siska-tech/kagura-hd/docs/pcm-stream-rc1-sta-audit.md

# PCMストリーミング RC1 STA改善監査

監査日: 2026-11-07。対象は `diagnostics/pcm-stream-rc1/` の3本のSTAパッチ、ビルド・再配置スクリプト、`build/pcm-stream-rc1/sta-short-control/` の保存済みRTL・ログ・STA。今回は静的レビューと保存証跡の照合を実施し、合成・シミュレーション・実機試験は再実行していない。

## 判定

改善方向は妥当。ただし採用保留。最良P4/R2はSetup +0.090 ns、Hold +0.530 ns、違反端点0/0であり、既定Setup +0.100 nsに0.010 ns不足する。CLS 4265/4320（残55）、BSRAM 23/26。数値は保存済み `native/timing-status.json` と `native/impl/pnr/kagura_fb.rpt.txt` に整合する。試験不足を解消してから次のSTA候補を評価する。

## 指摘

### P1: 新設した桁上がり境界の試験が未成立

`control-sta.patch` は `cursor[10:3]` の全ビットANDを登録し、上位 `cursor[19:11]` の加算に使う。cursorはbyteではなく32-bit word単位。対象は2048 wordごとの境界であり、例えばword 2044から16 wordを読み書きする試験が必要。

保存済み `sta-short-control/tb_fb_burst_ctrl.sv:65` の追加ケースはword 508から16 word。これは512 word境界で、分割した上位加算のcarry=1を検証しない。モデルは4096 byte、ランダム開始アドレスは0〜1008 wordで、正常転送の検証範囲も新境界に届かない。READMEの「桁上がり境界を確認した」は今回の変更に対する証拠として不十分。RTLの不具合を確認したものではなく、carry=1の動作保証が欠ける指摘である。

対応: モデルと期待メモリを拡大し、2044/2047開始のマスク付き書込み・読出し、複数の2048 word境界、carry後の次要求を試験する。アサートがcarry=1のPREPAREを実際に観測したことも記録する。

### P2: 回帰試験を新しい作業環境で再現する手順が不足

`build.ps1` はパッチ適用とP&R・数値ゲートを行うが、機能回帰は実行しない。READMEの実行例は `tb_stream` に限られ、境界追加済みバースト試験は `build/` 内、Queue8用基板トップ試験も生成済みファイルに依存する。HDMI比較のseed・REPLICATE_FIRST指定を含む一括再現手順と試験入力manifestがない。

保存ログにはHDMI比較3 seed、バースト、基板トップ回帰の実行証跡がある。packet-build.logのパラメータ警告からREPLICATE_FIRST=1でのビルドも確認でき、既存結果を否定する指摘ではない。ただし後のパッチ変更で検証を省略しやすい。

対応: 試験fixtureまたはその生成差分をdiagnostics側に保存し、assert有効・seed・対象入力hashを記録する回帰スクリプトを用意する。最終パッチ組合せでstream試験も含めて実行する。

## 妥当性と制約

- TXロード予測はIDLE維持、無効要求のCHECK→IDLE、GAP→IDLEを網羅する。シフト予測は通常転送のtickを1サイクル先読みし、現行LAT/RDL設定で元条件と整合する。既存assertは有効な防護。FSM変更時には予測条件も同時に変更する必要がある。
- HDMI式はfirst=(counter==0)、last=(counter==31)という既存不変条件から元のcounter_next==0と等価。既存の初期値とresetも整合する。
- cursorのcarryは要求受付後のCHECKで更新され、PREPAREで消費される。次バーストまでにも更新時間がある。静的レビューでは位相不整合は見つからなかったが、上記境界試験は必要。
- 窓選択の複製は大きなデータ保持段を増設しない方針に適合する。ただし受付条件を二重記述しており、CSR変更時の追随とbyte_commitとのassertを維持する必要がある。
- 最良版とRC1のSDCのSHA-256は一致（169C6026948136C552BB5AB498D3F44C84FA390342433AC3F993745F253C1AA0）。今回の改善は制約緩和によるものではない。
- そのSDC自体はdraft。system54/pixel74間の一律10 ns max-delay、同区間のhold除外、host入出力のfalse pathを含み、PSRAM外部IOの完全な仕様ではない。数値ゲート通過をCDCプロトコル・外部IO・実機動作の承認と扱わない。これは既存の評価範囲であり、新たに導入された欠陥ではない。
- 旧パレット配置指定の転用でSetupが−1.109 ns、bit181単独指定で−1.971 nsに悪化した。局所FFを寄せることと全体STA改善は一致しない。現行の内部配置指定なしP4/R2を保持し、全経路の数値で採否を決める。

## 次の順序

1. 桁上がり境界試験と回帰再現手順を整備する。
2. 同一入力を固定して追加候補を比較し、Setup +0.100 ns基準を維持する。+0.090 nsを丸めて合格にしない。
3. 数値ゲート達成後に、既存のCDC・外部IO評価範囲を明示した実機ストリーミング検証へ進む。

## 監査後の対応（2026-11-07）

P1/P2の機能検証・再現手順不足は対応済み。`diagnostics/pcm-stream-rc1/regress.py` と保存fixtureを追加し、RC1入力から全パッチを再適用して11実行が成功した。2048/4096/6144 word境界は3 seedそれぞれでcarry=1読出し6回・書込み6回を観測した。再生成した入力41ファイルは最良STA版と改行差を除いて一致。詳細は同ディレクトリのREADME、証跡は `build/pcm-stream-rc1/audit-regression/`。STA採用保留と実機未検証の判断は継続する。
