siska-tech/kagura-hd/docs/publication-audit.md

> 履歴資料：この文書の未検証・候補・公開保留などの記述は記録時点の状態です。最終版の選定と現行仕様は [リリース案内](release-validation.md) と [README](../README.md) を参照してください。

# KAGURA-HD 公開用スナップショットの監査

2026-11-04。公開先は https://github.com/siska-tech/kagura-hd です。GitHubリポジトリ作成とPushは最終承認待ちです。

## 公開対象と原本の保護

開発側488候補を全件選別し、旧Desktop・ゲーム・旧SDKの測定ログと画像、開発専用の整理台帳223ファイルを公開対象から除外しました。265ファイルを継承し、NOTICEと本記録の2ファイルを追加した **267ファイル** を初期公開対象とします。

開発ツリー、未コミット変更、ローカルバックアップを保護しています。全488ファイルの開始時SHA-256との照合で開発ファイルの変更は0件でした。公開側のRTL・基板・モデル・ドライバ・第三者コードも内容を維持しています。kagura_fb_*、KFB1、ABI 1.2、API名、公開対象のソースパスを維持しました。

共通部品と診断Topの再ビルド用に継承RTL・制約・診断ツールを保持しました。旧仕様入力や設計資料は診断構成の背景資料です。現行仕様は [README](../README.md) と [ホストABI](kagura-fb-host-api.md) に示しています。原本の選別一覧と除外理由は開発側 build/publication-audit/file-decisions.csv に保存しています。

## READMEと参照の監査

READMEを正式名称 KAGURA-HD、現行仕様、ビルド方法、実測の検証値、実機未検証事項に合わせて全面改訂しました。過去の設計・実装記録と継承した診断資料には、当時の名称・ABI・数値を現行仕様と区別する注記を追加しました。

旧資料への相対リンク21件を継承元の固定コミットへ変更しました。全Markdownのローカルリンクとアンカーを走査し、参照先不明は0件です。外部URL38件は、公開先の作成待ち1件を除き参照先を確認しました。Raspberry Piの公式仕様ページはHTTP HEADで403となったため、別の閲覧経路で公式ページの内容を確認しました。

Dynabook手順のSPI例は既存connect_rp2040()を使う形に修正しました。指定のGP2/3、GP6/7配線に対してSoftSPIを生成する実装を使用します。

秘密鍵ヘッダ、GitHub token、AWS access key、直接代入された長い秘密文字列のパターン検査は該当0件です。個人ホームの固定絶対パスを資料から除去しました。Gowinの上書き可能な既定インストール先と、説明用プレースホルダーは保持しています。1 MiB超の公開ファイルは0件で、bitstream・波形・キャッシュ・生成物はGit管理対象に含めません。

## 公開スナップショットからのクリーン検証

|検査|結果|
|---|---|
|Verilator 5.032、seed 1 のFB回帰|26件合格|
|共通HDMI・音声・メモリの直接回帰|22構成合格|
|C/Pythonドライバ|15件合格|
|MicroPython Unix v1.26.0|3グループ合格|
|BLIT解析|終了コード0|
|HDMI固定依存SHA-256|12ファイル一致|
|全公開シェル入口|bash構文検査合格|
|CI設定|YAML解析、実行入口と固定タグのコミット一致を確認|

CIのVerilatorタグv5.032は8ff77e9d47351b0a59114929880687839a51840b、MicroPython v1.26.0は4ce2dd2cdab6e57f3982fc899f15a2103d71b0beに一致しました。実MicroPython試験にも後者のソースからビルドしたランタイムを使用しました。GitHub Actions上での実行はリポジトリ公開後の確認対象です。

既存ソースのCRLFと第三者原版の空白を維持しています。初期コミット全体の空白検査には継承ファイルの末尾空白・末尾空行の警告が残ります。これは既存ソースの表記を保持した結果で、RTLやドライバの書換えによる整形は行っていません。

## Gowin SPI/QSPIのクリーンP&R

Gowin Education 1.9.11.03で公開スナップショットから新規に合成・配置配線しました。

|構成|Logic|FF合計|CLS|BSRAM|DSP|Setup ns|Hold ns|違反|
|---|---|---|---|---|---|---|---|---|
|spi|7815|5227|4245|19|1|1.122|0.558|0|
|qspi|7795|5230|4223|19|1|0.66|0.552|0|

資源・slackは開発側と一致しました。SPI/QSPIの.binは開発側とバイト単位に完全一致しました。.fsと.binxは生成時刻ヘッダのみが異なりました。SHA-256は次のとおりです。

- spi .bin `9cf73240289361fa89cbb4affb2821da210896a47298578b279656fb3ee045cf`
- spi .fs `ea716f2c7ecee681c2a4b6fe13b62629d473dade7d454e42d3abdd8b7a1387b0`
- qspi .bin `2b51dfe0c120d1cf4b4438d366239b1a13a76ca7dbb74ec619583f76381c1b14`
- qspi .fs `57d3e2262d12b644c4a7edd8ac864b51ef56637ffcc6499ed0a68d6221752bc5`

数値STAは合格しています。CDC制約の妥当性、外部PSRAM I/Oタイミング、実機の映像・音声品質と最大ホスト速度、長時間安定性は未検証です。timing-status.jsonのrelease_readyはfalseです。実機書込み・接続は今回実施していません。

## ライセンスと初期コミット

本体は [Apache-2.0](../LICENSE) です。[NOTICE](../NOTICE)、[第三者表記](../THIRD_PARTY.md)、[継承元](kagura-fb-separation.md)を保持しました。hdl-util/hdmiはApache-2.0側を選択し、Copyright 2019 Sameer PuriとMIT/Apache-2.0の両本文を保持しています。

公開側に新規Gitリポジトリとmainブランチを作成し、旧履歴を取り込まず、この検証済み内容の単独初期コミットを準備します。初期コミットIDはgit rev-parse HEADで確認できます。originは承認済み公開先に設定しました。GitHubのリポジトリ作成とPushはユーザーの最終承認待ちです。
