siska-tech/kagura-hd/releases/pcm2-spi/reports/kagura_fb.rpt.html

- PnR Messages
- PnR Details
- Resource
  - Resource Usage Summary
  - I/O Bank Usage Summary
  - Clock Resource Usage Summary
  - Global Clock Signals
  - Pinout by Port Name
  - All Package Pins

# PnR Messages

Report Title | PnR Report
Design File | C:\Users\Shion\Documents\Projects\kagura-hd\build\kagura-fb\impl\gwsynthesis\kagura_fb.vg
Physical Constraints File | C:\Users\Shion\Documents\Projects\kagura-hd\build\kagura-fb\kagura_fb.cst
Timing Constraints File | C:\Users\Shion\Documents\Projects\kagura-hd\boards\tang-nano-9k\kagura-fb.sdc
Tool Version | V1.9.12.04 (64-bit)
Part Number | GW1NR-LV9QN88PC6/I5
Device | GW1NR-9
Device Version | C
Created Time | Fri Nov 6 07:12:30 2026
Legal Announcement | Copyright (C)2014-2026 Gowin Semiconductor Corporation. All rights reserved.

# PnR Details

Place & Route Process

Running placement: Placement Phase 0: CPU time = 0h 0m 15s, Elapsed time = 0h 0m 15s Placement Phase 1: CPU time = 0h 0m 0.326s, Elapsed time = 0h 0m 0.327s Placement Phase 2: CPU time = 0h 0m 4s, Elapsed time = 0h 0m 4s Placement Phase 3: CPU time = 0h 1m 2s, Elapsed time = 0h 1m 2s Total Placement: CPU time = 0h 1m 21s, Elapsed time = 0h 1m 21s Running routing: Routing Phase 0: CPU time = 0h 0m 0.017s, Elapsed time = 0h 0m 0.017s Routing Phase 1: CPU time = 0h 0m 14s, Elapsed time = 0h 0m 14s Routing Phase 2: CPU time = 0h 2m 11s, Elapsed time = 0h 2m 11s Routing Phase 3: CPU time = 0h 0m 0s, Elapsed time = 0h 0m 0s Total Routing: CPU time = 0h 2m 25s, Elapsed time = 0h 2m 25s Generate output files: CPU time = 0h 0m 1s, Elapsed time = 0h 0m 1s
Total Time and Memory Usage | CPU time = 0h 3m 47s, Elapsed time = 0h 3m 47s, Peak memory usage = 364MB

# Resource

## Resource Usage Summary:

Resource | Usage | Utilization
Logic | 7810/8640 | 91%
--LUT,ALU,ROM16 | 7714(6693 LUT, 1021 ALU, 0 ROM16) | -
--SSRAM(RAM16) | 16 | -
Register | 5236/6771 | 78%
--Logic Register as Latch | 0/6480 | 0%
--Logic Register as FF | 5230/6480 | 81%
--I/O Register as Latch | 0/291 | 0%
--I/O Register as FF | 6/291 | 3%
CLS | 4213/4320 | 98%
I/O Port | 29/71 | 41%
I/O Buf | 25 | -
--Input Buf | 4 | -
--Output Buf | 20 | -
--Inout Buf | 1 | -
IOLOGIC | 8 IDDR 12 ODDR 4 OSER10 | 29%
BSRAM | 16 SP 3 SDPB | 74%
DSP | 2 MULT18X18 | 10%

## I/O Bank Usage Summary:

I/O Bank | Usage | Utilization
bank 1 | 10/25 | 40%
bank 2 | 12/23 | 53%
bank 3 | 7/23 | 31%

## Clock Resource Usage Summary:

Clock Resource | Usage | Utilization
PRIMARY | 5/8 | 63%
LW | 8/8 | 100%
GCLK_PIN | 3/3 | 100%
CLKDIV | 1/8 | 13%
rPLL | 2/2 | 100%

## Global Clock Signals:

Signal | Global Clock | Location
clk27_d | PRIMARY | TR TL
pixel | PRIMARY | TR TL BR BL
system_clk | PRIMARY | TR TL BR BL
psram_ck | PRIMARY | TL
core/memory_ctrl/tx_495_9 | PRIMARY | TR TL BR BL
reset | LW | -
n2364_5 | LW | -
core/pix_release[2] | LW | -
core/display/n8_7 | LW | -
core/display/n3059_3 | LW | -
core/hdmi/protocol/true_hdmi_output.packet_enable | LW | -
core/hdmi/protocol/true_hdmi_output.data_island_period | LW | -
core/memory_ctrl/n19_6 | LW | -
serial | HCLK | BANK0_BANK1_HCLK0

## Pinout by Port Name:

Port Name | Diff Pair | Loc./Bank | Constraint | Dir. | Site | CFG | IO Type | Drive | Pull Mode | PCI Clamp | Hysteresis | Open Drain | Vref | Single Resistor | Diff Resistor | BankVccio
clk27 | - | 52/1 | Y | in | IOR17[A] | GCLKT_3 | LVCMOS33 | NA | NONE | ON | NONE | NA | NA | OFF | NA | 3.3
reset_n | - | 4/3 | Y | in | IOL5[A] | JTAGSEL_N/LPLL_T_in | LVCMOS18 | NA | UP | ON | NONE | NA | NA | OFF | NA | 1.8
host_sck | - | 35/2 | Y | in | IOB29[A] | GCLKT_4 | LVCMOS33 | NA | DOWN | ON | NONE | NA | NA | NA | NA | 3.3
host_cs_n | - | 42/2 | Y | in | IOB41[B] | - | LVCMOS33 | NA | UP | ON | NONE | NA | NA | NA | NA | 3.3
host_busy | - | 26/2 | Y | out | IOB8[B] | - | LVCMOS33 | 8 | UP | NA | NA | OFF | NA | NA | NA | 3.3
host_ready | - | 27/2 | Y | out | IOB11[A] | - | LVCMOS33 | 8 | DOWN | NA | NA | OFF | NA | NA | NA | 3.3
host_irq_n | - | 49/1 | Y | out | IOR24[A] | - | LVCMOS33 | 8 | UP | NA | NA | OFF | NA | OFF | NA | 3.3
sd_hiz[0] | - | 36/2 | Y | out | IOB29[B] | GCLKC_4 | LVCMOS33 | 8 | NONE | NA | NA | OFF | NA | NA | NA | 3.3
sd_hiz[1] | - | 37/2 | Y | out | IOB31[A] | - | LVCMOS33 | 8 | NONE | NA | NA | OFF | NA | NA | NA | 3.3
sd_hiz[2] | - | 38/2 | Y | out | IOB31[B] | - | LVCMOS33 | 8 | NONE | NA | NA | OFF | NA | NA | NA | 3.3
sd_hiz[3] | - | 39/2 | Y | out | IOB33[A] | - | LVCMOS33 | 8 | NONE | NA | NA | OFF | NA | NA | NA | 3.3
tmds_clk_p | tmds_clk_n | 69/1 | Y | out | IOT42[A] | - | LVCMOS33D | 8 | NONE | NA | NA | NA | NA | OFF | NA | 3.3
tmds_clk_n | tmds_clk_p | 68/1 | Y | out | IOT42[B] | - | LVCMOS33D | 8 | NONE | NA | NA | NA | NA | OFF | NA | 3.3
tmds_d_p[0] | tmds_d_n[0] | 71/1 | Y | out | IOT41[A] | - | LVCMOS33D | 8 | NONE | NA | NA | NA | NA | OFF | NA | 3.3
tmds_d_p[1] | tmds_d_n[1] | 73/1 | Y | out | IOT39[A] | - | LVCMOS33D | 8 | NONE | NA | NA | NA | NA | OFF | NA | 3.3
tmds_d_p[2] | tmds_d_n[2] | 75/1 | Y | out | IOT38[A] | - | LVCMOS33D | 8 | NONE | NA | NA | NA | NA | OFF | NA | 3.3
tmds_d_n[0] | tmds_d_p[0] | 70/1 | Y | out | IOT41[B] | - | LVCMOS33D | 8 | NONE | NA | NA | NA | NA | OFF | NA | 3.3
tmds_d_n[1] | tmds_d_p[1] | 72/1 | Y | out | IOT39[B] | - | LVCMOS33D | 8 | NONE | NA | NA | NA | NA | OFF | NA | 3.3
tmds_d_n[2] | tmds_d_p[2] | 74/1 | Y | out | IOT38[B] | - | LVCMOS33D | 8 | NONE | NA | NA | NA | NA | OFF | NA | 3.3
led_n[0] | - | 10/3 | Y | out | IOL15[A] | GCLKT_6 | LVCMOS18 | 8 | UP | NA | NA | OFF | NA | OFF | NA | 1.8
led_n[1] | - | 11/3 | Y | out | IOL16[B] | - | LVCMOS18 | 8 | UP | NA | NA | OFF | NA | OFF | NA | 1.8
led_n[2] | - | 13/3 | Y | out | IOL21[B] | - | LVCMOS18 | 8 | UP | NA | NA | OFF | NA | OFF | NA | 1.8
led_n[3] | - | 14/3 | Y | out | IOL22[B] | - | LVCMOS18 | 8 | UP | NA | NA | OFF | NA | OFF | NA | 1.8
led_n[4] | - | 15/3 | Y | out | IOL25[B] | - | LVCMOS18 | 8 | UP | NA | NA | OFF | NA | OFF | NA | 1.8
led_n[5] | - | 16/3 | Y | out | IOL26[B] | - | LVCMOS18 | 8 | UP | NA | NA | OFF | NA | OFF | NA | 1.8
O_psram_ck[0] | - | p1-7/3 | - | out | IOL8[A] | - | LVCMOS18 | - | UP | - | - | - | - | - | - | -
O_psram_ck[1] | - | p2-7/3 | - | out | IOL23[B] | - | LVCMOS18 | - | UP | - | - | - | - | - | - | -
O_psram_ck_n[0] | - | p1-8/3 | - | out | IOL7[A] | - | LVCMOS18 | - | UP | - | - | - | - | - | - | -
O_psram_ck_n[1] | - | p2-8/3 | - | out | IOL23[A] | - | LVCMOS18 | - | UP | - | - | - | - | - | - | -
O_psram_reset_n[0] | - | p1-14/3 | - | out | IOL2[A] | - | LVCMOS18 | - | UP | - | - | - | - | - | - | -
O_psram_reset_n[1] | - | p2-14/3 | - | out | IOL18[A] | - | LVCMOS18 | - | UP | - | - | - | - | - | - | -
O_psram_cs_n[0] | - | p1-9/3 | - | out | IOL6[B] | LPLL_C_fb | LVCMOS18 | - | UP | - | - | - | - | - | - | -
O_psram_cs_n[1] | - | p2-9/3 | - | out | IOL22[A] | - | LVCMOS18 | - | UP | - | - | - | - | - | - | -
host_io[0] | - | 28/2 | Y | io | IOB11[B] | - | LVCMOS33 | 8 | UP | NA | NONE | OFF | NA | NA | NA | 3.3
host_io[1] | - | 29/2 | Y | io | IOB13[A] | - | LVCMOS33 | 8 | UP | NA | NA | OFF | NA | NA | NA | 3.3
host_io[2] | - | 30/2 | Y | io | IOB13[B] | - | LVCMOS33 | 8 | UP | NA | NA | OFF | NA | NA | NA | 3.3
host_io[3] | - | 33/2 | Y | io | IOB23[A] | - | LVCMOS33 | 8 | UP | NA | NA | OFF | NA | NA | NA | 3.3
IO_psram_rwds[0] | - | p1-2/3 | - | io | IOL17[A] | - | LVCMOS18 | - | UP | - | - | - | - | - | - | -
IO_psram_rwds[1] | - | p2-2/3 | - | io | IOL27[B] | - | LVCMOS18 | - | UP | - | - | - | - | - | - | -
IO_psram_dq[0] | - | p1-13/3 | - | io | IOL2[B] | - | LVCMOS18 | - | UP | - | - | - | - | - | - | -
IO_psram_dq[1] | - | p1-12/3 | - | io | IOL3[A] | - | LVCMOS18 | - | UP | - | - | - | - | - | - | -
IO_psram_dq[2] | - | p1-11/3 | - | io | IOL3[B] | - | LVCMOS18 | - | UP | - | - | - | - | - | - | -
IO_psram_dq[3] | - | p1-10/3 | - | io | IOL4[A] | - | LVCMOS18 | - | UP | - | - | - | - | - | - | -
IO_psram_dq[4] | - | p1-6/3 | - | io | IOL9[A] | GCLKT_7 | LVCMOS18 | - | UP | - | - | - | - | - | - | -
IO_psram_dq[5] | - | p1-5/3 | - | io | IOL14[A] | DONE | LVCMOS18 | - | UP | - | - | - | - | - | - | -
IO_psram_dq[6] | - | p1-4/3 | - | io | IOL16[A] | - | LVCMOS18 | - | UP | - | - | - | - | - | - | -
IO_psram_dq[7] | - | p1-3/3 | - | io | IOL17[B] | - | LVCMOS18 | - | UP | - | - | - | - | - | - | -
IO_psram_dq[8] | - | p2-13/3 | - | io | IOL18[B] | - | LVCMOS18 | - | UP | - | - | - | - | - | - | -
IO_psram_dq[9] | - | p2-12/3 | - | io | IOL20[A] | - | LVCMOS18 | - | UP | - | - | - | - | - | - | -
IO_psram_dq[10] | - | p2-11/3 | - | io | IOL20[B] | - | LVCMOS18 | - | UP | - | - | - | - | - | - | -
IO_psram_dq[11] | - | p2-10/3 | - | io | IOL21[A] | - | LVCMOS18 | - | UP | - | - | - | - | - | - | -
IO_psram_dq[12] | - | p2-6/3 | - | io | IOL24[B] | - | LVCMOS18 | - | UP | - | - | - | - | - | - | -
IO_psram_dq[13] | - | p2-5/3 | - | io | IOL25[A] | - | LVCMOS18 | - | UP | - | - | - | - | - | - | -
IO_psram_dq[14] | - | p2-4/3 | - | io | IOL26[A] | - | LVCMOS18 | - | UP | - | - | - | - | - | - | -
IO_psram_dq[15] | - | p2-3/3 | - | io | IOL27[A] | - | LVCMOS18 | - | UP | - | - | - | - | - | - | -

## All Package Pins:

Loc./Bank | Signal | Dir. | Site | CFG | IO Type | Drive | Pull Mode | PCI Clamp | Hysteresis | Open Drain | Vref | Single Resistor | Diff Resistor | Bank Vccio
3/3 | - | in | IOT2[A] | - | LVCMOS18 | NA | UP | ON | NONE | NA | NA | NA | NA | 1.8
88/3 | - | in | IOT5[A] | MODE0 | LVCMOS18 | NA | UP | ON | NONE | NA | NA | NA | NA | 1.8
87/3 | - | in | IOT6[B] | MODE1 | LVCMOS18 | NA | UP | ON | NONE | NA | NA | NA | NA | 1.8
86/3 | - | in | IOT8[A] | - | LVCMOS18 | NA | UP | ON | NONE | NA | NA | NA | NA | 1.8
85/3 | - | in | IOT8[B] | - | LVCMOS18 | NA | UP | ON | NONE | NA | NA | NA | NA | 1.8
84/3 | - | in | IOT10[A] | - | LVCMOS18 | NA | UP | ON | NONE | NA | NA | NA | NA | 1.8
83/3 | - | in | IOT10[B] | - | LVCMOS18 | NA | UP | ON | NONE | NA | NA | NA | NA | 1.8
82/3 | - | in | IOT11[A] | - | LVCMOS18 | NA | UP | ON | NONE | NA | NA | NA | NA | 1.8
81/3 | - | in | IOT11[B] | - | LVCMOS18 | NA | UP | ON | NONE | NA | NA | NA | NA | 1.8
80/3 | - | in | IOT12[A] | - | LVCMOS18 | NA | UP | ON | NONE | NA | NA | NA | NA | 1.8
79/3 | - | in | IOT12[B] | - | LVCMOS18 | NA | UP | ON | NONE | NA | NA | NA | NA | 1.8
77/1 | - | in | IOT37[A] | - | LVCMOS33 | NA | UP | ON | NONE | NA | NA | NA | NA | 3.3
76/1 | - | in | IOT37[B] | - | LVCMOS33 | NA | UP | ON | NONE | NA | NA | NA | NA | 3.3
75/1 | tmds_d_p[2] | out | IOT38[A] | - | LVCMOS33D | 8 | NONE | NA | NA | NA | NA | OFF | NA | 3.3
74/1 | tmds_d_n[2] | out | IOT38[B] | - | LVCMOS33D | 8 | NONE | NA | NA | NA | NA | OFF | NA | 3.3
73/1 | tmds_d_p[1] | out | IOT39[A] | - | LVCMOS33D | 8 | NONE | NA | NA | NA | NA | OFF | NA | 3.3
72/1 | tmds_d_n[1] | out | IOT39[B] | - | LVCMOS33D | 8 | NONE | NA | NA | NA | NA | OFF | NA | 3.3
71/1 | tmds_d_p[0] | out | IOT41[A] | - | LVCMOS33D | 8 | NONE | NA | NA | NA | NA | OFF | NA | 3.3
70/1 | tmds_d_n[0] | out | IOT41[B] | - | LVCMOS33D | 8 | NONE | NA | NA | NA | NA | OFF | NA | 3.3
69/1 | tmds_clk_p | out | IOT42[A] | - | LVCMOS33D | 8 | NONE | NA | NA | NA | NA | OFF | NA | 3.3
68/1 | tmds_clk_n | out | IOT42[B] | - | LVCMOS33D | 8 | NONE | NA | NA | NA | NA | OFF | NA | 3.3
17/2 | - | in | IOB2[A] | - | LVCMOS33 | NA | UP | ON | NONE | NA | NA | NA | NA | 3.3
18/2 | - | in | IOB2[B] | - | LVCMOS33 | NA | UP | ON | NONE | NA | NA | NA | NA | 3.3
19/2 | - | in | IOB4[A] | - | LVCMOS33 | NA | UP | ON | NONE | NA | NA | NA | NA | 3.3
20/2 | - | in | IOB4[B] | - | LVCMOS33 | NA | UP | ON | NONE | NA | NA | NA | NA | 3.3
25/2 | - | in | IOB8[A] | - | LVCMOS33 | NA | UP | ON | NONE | NA | NA | NA | NA | 3.3
26/2 | host_busy | out | IOB8[B] | - | LVCMOS33 | 8 | UP | NA | NA | OFF | NA | NA | NA | 3.3
27/2 | host_ready | out | IOB11[A] | - | LVCMOS33 | 8 | DOWN | NA | NA | OFF | NA | NA | NA | 3.3
28/2 | host_io[0] | io | IOB11[B] | - | LVCMOS33 | 8 | UP | NA | NONE | OFF | NA | NA | NA | 3.3
29/2 | host_io[1] | out | IOB13[A] | - | LVCMOS33 | 8 | UP | NA | NA | OFF | NA | NA | NA | 3.3
30/2 | host_io[2] | out | IOB13[B] | - | LVCMOS33 | 8 | UP | NA | NA | OFF | NA | NA | NA | 3.3
31/2 | - | in | IOB15[A] | - | LVCMOS33 | NA | UP | ON | NONE | NA | NA | NA | NA | 3.3
32/2 | - | in | IOB15[B] | - | LVCMOS33 | NA | UP | ON | NONE | NA | NA | NA | NA | 3.3
33/2 | host_io[3] | out | IOB23[A] | - | LVCMOS33 | 8 | UP | NA | NA | OFF | NA | NA | NA | 3.3
34/2 | - | in | IOB23[B] | - | LVCMOS33 | NA | UP | ON | NONE | NA | NA | NA | NA | 3.3
35/2 | host_sck | in | IOB29[A] | GCLKT_4 | LVCMOS33 | NA | DOWN | ON | NONE | NA | NA | NA | NA | 3.3
36/2 | sd_hiz[0] | out | IOB29[B] | GCLKC_4 | LVCMOS33 | 8 | NONE | NA | NA | OFF | NA | NA | NA | 3.3
37/2 | sd_hiz[1] | out | IOB31[A] | - | LVCMOS33 | 8 | NONE | NA | NA | OFF | NA | NA | NA | 3.3
38/2 | sd_hiz[2] | out | IOB31[B] | - | LVCMOS33 | 8 | NONE | NA | NA | OFF | NA | NA | NA | 3.3
39/2 | sd_hiz[3] | out | IOB33[A] | - | LVCMOS33 | 8 | NONE | NA | NA | OFF | NA | NA | NA | 3.3
40/2 | - | in | IOB33[B] | - | LVCMOS33 | NA | UP | ON | NONE | NA | NA | NA | NA | 3.3
41/2 | - | in | IOB41[A] | - | LVCMOS33 | NA | UP | ON | NONE | NA | NA | NA | NA | 3.3
42/2 | host_cs_n | in | IOB41[B] | - | LVCMOS33 | NA | UP | ON | NONE | NA | NA | NA | NA | 3.3
47/2 | - | in | IOB43[B] | - | LVCMOS33 | NA | UP | ON | NONE | NA | NA | NA | NA | 3.3
p1-14/3 | O_psram_reset_n[0] | out | IOL2[A] | - | LVCMOS18 | - | UP | - | - | - | - | - | - | -
p1-13/3 | IO_psram_dq[0] | io | IOL2[B] | - | LVCMOS18 | - | UP | - | - | - | - | - | - | -
p1-12/3 | IO_psram_dq[1] | io | IOL3[A] | - | LVCMOS18 | - | UP | - | - | - | - | - | - | -
p1-11/3 | IO_psram_dq[2] | io | IOL3[B] | - | LVCMOS18 | - | UP | - | - | - | - | - | - | -
p1-10/3 | IO_psram_dq[3] | io | IOL4[A] | - | LVCMOS18 | - | UP | - | - | - | - | - | - | -
4/3 | reset_n | in | IOL5[A] | JTAGSEL_N/LPLL_T_in | LVCMOS18 | NA | UP | ON | NONE | NA | NA | OFF | NA | 1.8
p1-9/3 | O_psram_cs_n[0] | out | IOL6[B] | LPLL_C_fb | LVCMOS18 | - | UP | - | - | - | - | - | - | -
p1-8/3 | O_psram_ck_n[0] | out | IOL7[A] | - | LVCMOS18 | - | UP | - | - | - | - | - | - | -
p1-7/3 | O_psram_ck[0] | out | IOL8[A] | - | LVCMOS18 | - | UP | - | - | - | - | - | - | -
p1-6/3 | IO_psram_dq[4] | io | IOL9[A] | GCLKT_7 | LVCMOS18 | - | UP | - | - | - | - | - | - | -
5/3 | - | in | IOL11[A] | TMS | LVCMOS18 | NA | UP | ON | NONE | NA | NA | NA | NA | 1.8
6/3 | - | in | IOL11[B] | TCK | LVCMOS18 | NA | UP | ON | NONE | NA | NA | NA | NA | 1.8
7/3 | - | in | IOL12[B] | TDI | LVCMOS18 | NA | UP | ON | NONE | NA | NA | NA | NA | 1.8
8/3 | - | out | IOL13[A] | TDO | LVCMOS18 | 8 | UP | NA | NA | OFF | NA | NA | NA | 1.8
9/3 | - | in | IOL13[B] | RECONFIG_N | LVCMOS18 | NA | UP | ON | NONE | NA | NA | NA | NA | 1.8
p1-5/3 | IO_psram_dq[5] | io | IOL14[A] | DONE | LVCMOS18 | - | UP | - | - | - | - | - | - | -
10/3 | led_n[0] | out | IOL15[A] | GCLKT_6 | LVCMOS18 | 8 | UP | NA | NA | OFF | NA | OFF | NA | 1.8
p1-4/3 | IO_psram_dq[6] | io | IOL16[A] | - | LVCMOS18 | - | UP | - | - | - | - | - | - | -
11/3 | led_n[1] | out | IOL16[B] | - | LVCMOS18 | 8 | UP | NA | NA | OFF | NA | OFF | NA | 1.8
p1-2/3 | IO_psram_rwds[0] | io | IOL17[A] | - | LVCMOS18 | - | UP | - | - | - | - | - | - | -
p1-3/3 | IO_psram_dq[7] | io | IOL17[B] | - | LVCMOS18 | - | UP | - | - | - | - | - | - | -
p2-14/3 | O_psram_reset_n[1] | out | IOL18[A] | - | LVCMOS18 | - | UP | - | - | - | - | - | - | -
p2-13/3 | IO_psram_dq[8] | out | IOL18[B] | - | LVCMOS18 | - | UP | - | - | - | - | - | - | -
p2-12/3 | IO_psram_dq[9] | out | IOL20[A] | - | LVCMOS18 | - | UP | - | - | - | - | - | - | -
p2-11/3 | IO_psram_dq[10] | out | IOL20[B] | - | LVCMOS18 | - | UP | - | - | - | - | - | - | -
p2-10/3 | IO_psram_dq[11] | out | IOL21[A] | - | LVCMOS18 | - | UP | - | - | - | - | - | - | -
13/3 | led_n[2] | out | IOL21[B] | - | LVCMOS18 | 8 | UP | NA | NA | OFF | NA | OFF | NA | 1.8
p2-9/3 | O_psram_cs_n[1] | out | IOL22[A] | - | LVCMOS18 | - | UP | - | - | - | - | - | - | -
14/3 | led_n[3] | out | IOL22[B] | - | LVCMOS18 | 8 | UP | NA | NA | OFF | NA | OFF | NA | 1.8
p2-8/3 | O_psram_ck_n[1] | out | IOL23[A] | - | LVCMOS18 | - | UP | - | - | - | - | - | - | -
p2-7/3 | O_psram_ck[1] | out | IOL23[B] | - | LVCMOS18 | - | UP | - | - | - | - | - | - | -
p2-6/3 | IO_psram_dq[12] | out | IOL24[B] | - | LVCMOS18 | - | UP | - | - | - | - | - | - | -
p2-5/3 | IO_psram_dq[13] | out | IOL25[A] | - | LVCMOS18 | - | UP | - | - | - | - | - | - | -
15/3 | led_n[4] | out | IOL25[B] | - | LVCMOS18 | 8 | UP | NA | NA | OFF | NA | OFF | NA | 1.8
p2-4/3 | IO_psram_dq[14] | out | IOL26[A] | - | LVCMOS18 | - | UP | - | - | - | - | - | - | -
16/3 | led_n[5] | out | IOL26[B] | - | LVCMOS18 | 8 | UP | NA | NA | OFF | NA | OFF | NA | 1.8
p2-3/3 | IO_psram_dq[15] | out | IOL27[A] | - | LVCMOS18 | - | UP | - | - | - | - | - | - | -
p2-2/3 | IO_psram_rwds[1] | out | IOL27[B] | - | LVCMOS18 | - | UP | - | - | - | - | - | - | -
63/1 | - | in | IOR5[A] | RPLL_T_in | LVCMOS33 | NA | UP | ON | NONE | NA | NA | NA | NA | 3.3
62/1 | - | in | IOR11[A] | MI/D7 | LVCMOS33 | NA | UP | ON | NONE | NA | NA | NA | NA | 3.3
61/1 | - | in | IOR11[B] | MO/D6 | LVCMOS33 | NA | UP | ON | NONE | NA | NA | NA | NA | 3.3
60/1 | - | in | IOR12[A] | MCS_N/D5 | LVCMOS33 | NA | UP | ON | NONE | NA | NA | NA | NA | 3.3
59/1 | - | in | IOR12[B] | MCLK/D4 | LVCMOS33 | NA | UP | ON | NONE | NA | NA | NA | NA | 3.3
57/1 | - | in | IOR13[A] | FASTRD_N/D3 | LVCMOS33 | NA | UP | ON | NONE | NA | NA | NA | NA | 3.3
56/1 | - | in | IOR14[A] | SO/D1 | LVCMOS33 | NA | UP | ON | NONE | NA | NA | NA | NA | 3.3
55/1 | - | in | IOR14[B] | SSPI_CS_N/D0 | LVCMOS33 | NA | UP | ON | NONE | NA | NA | NA | NA | 3.3
54/1 | - | in | IOR15[A] | DIN/CLKHOLD_N | LVCMOS33 | NA | UP | ON | NONE | NA | NA | NA | NA | 3.3
53/1 | - | in | IOR15[B] | DOUT/WE_N | LVCMOS33 | NA | UP | ON | NONE | NA | NA | NA | NA | 3.3
52/1 | clk27 | in | IOR17[A] | GCLKT_3 | LVCMOS33 | NA | NONE | ON | NONE | NA | NA | OFF | NA | 3.3
51/1 | - | in | IOR17[B] | GCLKC_3 | LVCMOS33 | NA | UP | ON | NONE | NA | NA | NA | NA | 3.3
50/1 | - | in | IOR22[B] | - | LVCMOS33 | NA | UP | ON | NONE | NA | NA | NA | NA | 3.3
49/1 | host_irq_n | out | IOR24[A] | - | LVCMOS33 | 8 | UP | NA | NA | OFF | NA | OFF | NA | 3.3
48/1 | - | in | IOR24[B] | - | LVCMOS33 | NA | UP | ON | NONE | NA | NA | NA | NA | 3.3
