siska-tech/kagura-hd/docs/evidence/gpu-completion-abab/baseline-1/01.png

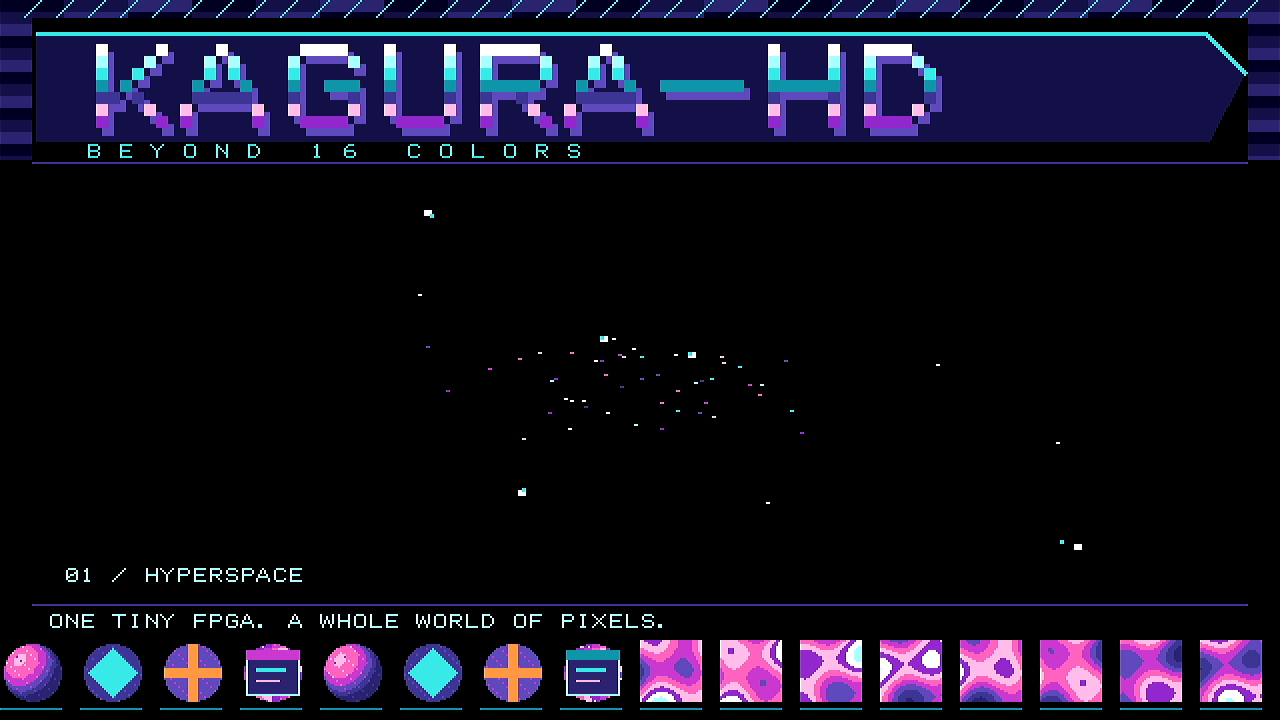
docs/evidence/gpu-completion-abab/baseline-1/01.png
