siska-tech/kagura-hd/docs/evidence/gpu-completion-abab/baseline-1/02.png

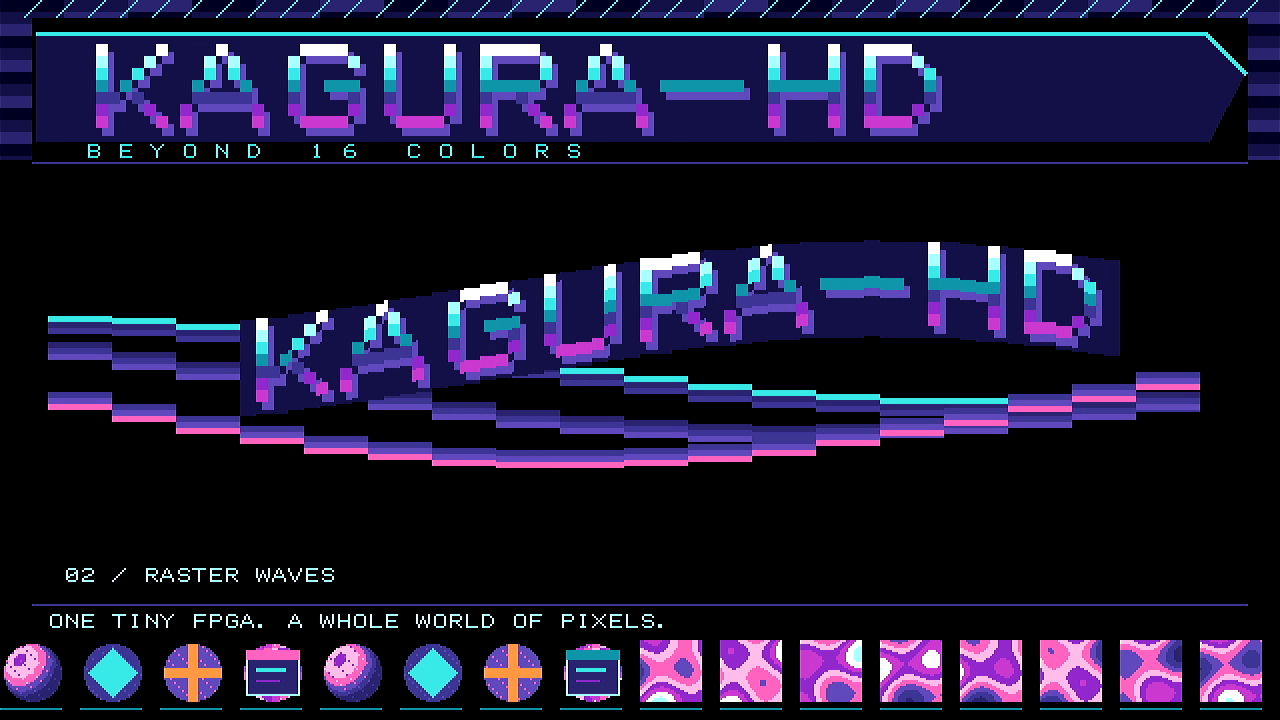
docs/evidence/gpu-completion-abab/baseline-1/02.png
