siska-tech/kagura-hd/docs/evidence/gpu-completion-abab/baseline-1/03.png

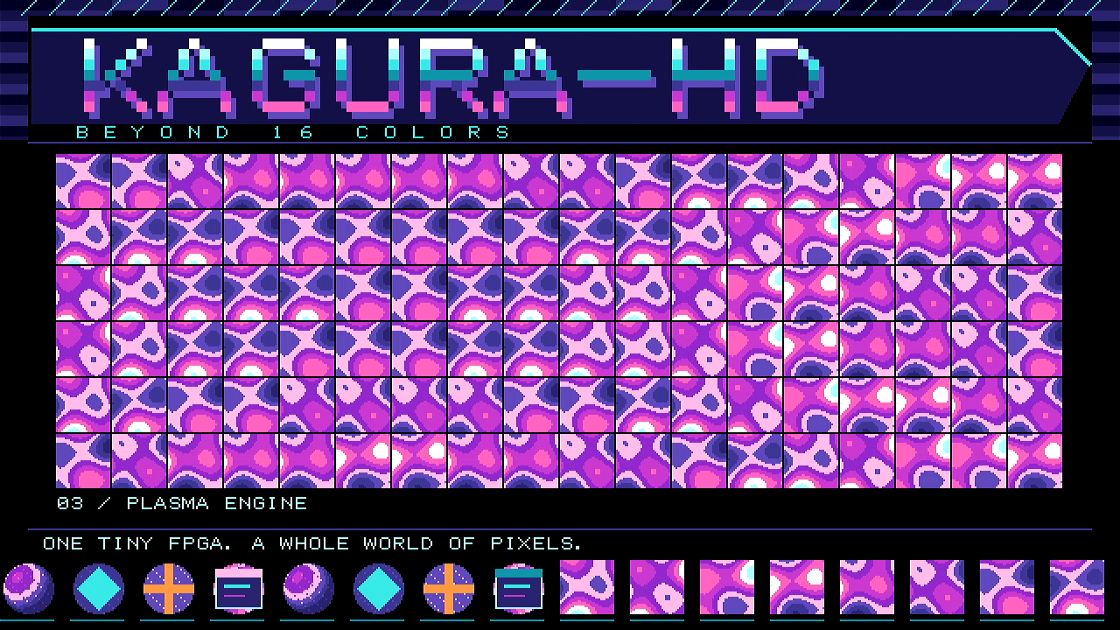
docs/evidence/gpu-completion-abab/baseline-1/03.png
