siska-tech/kagura-hd/docs/evidence/gpu-completion-abab/baseline-1/04.png

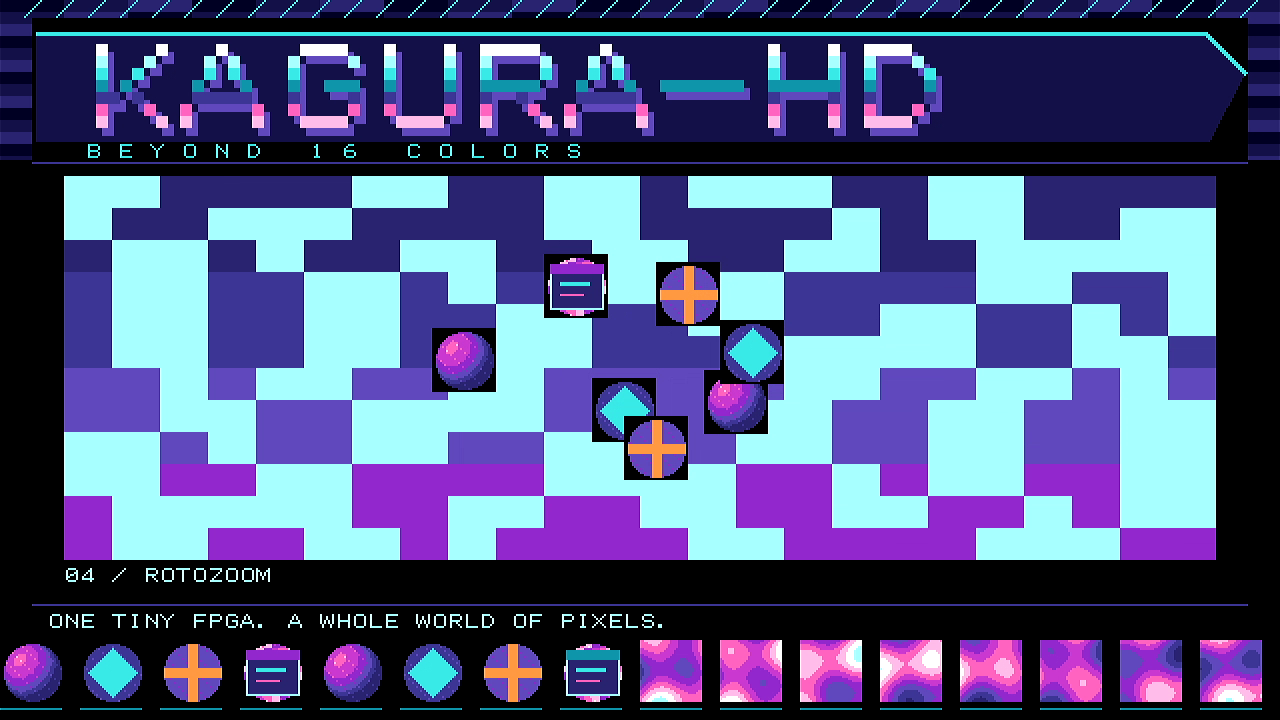
docs/evidence/gpu-completion-abab/baseline-1/04.png
