siska-tech/kagura-hd/docs/evidence/gpu-completion-abab/baseline-1/07.png

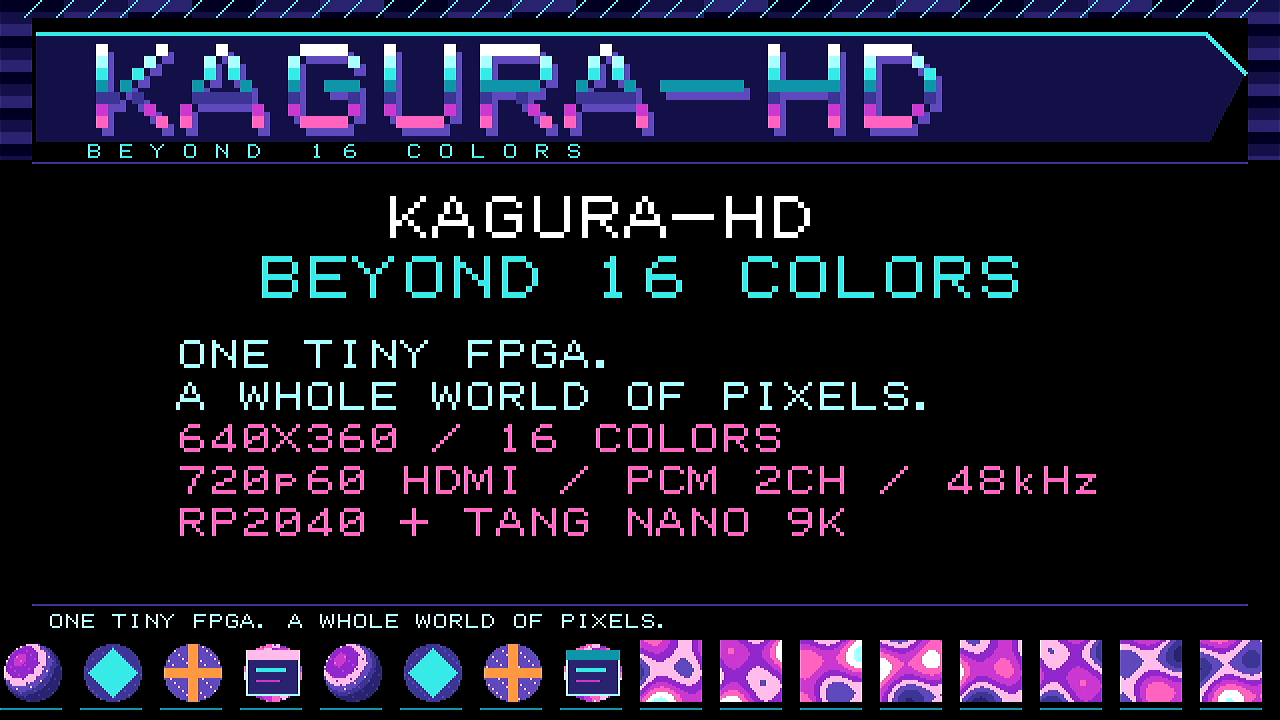
docs/evidence/gpu-completion-abab/baseline-1/07.png
