siska-tech/kagura-hd/docs/evidence/gpu-completion-abab/baseline-1/contact-sheet.png

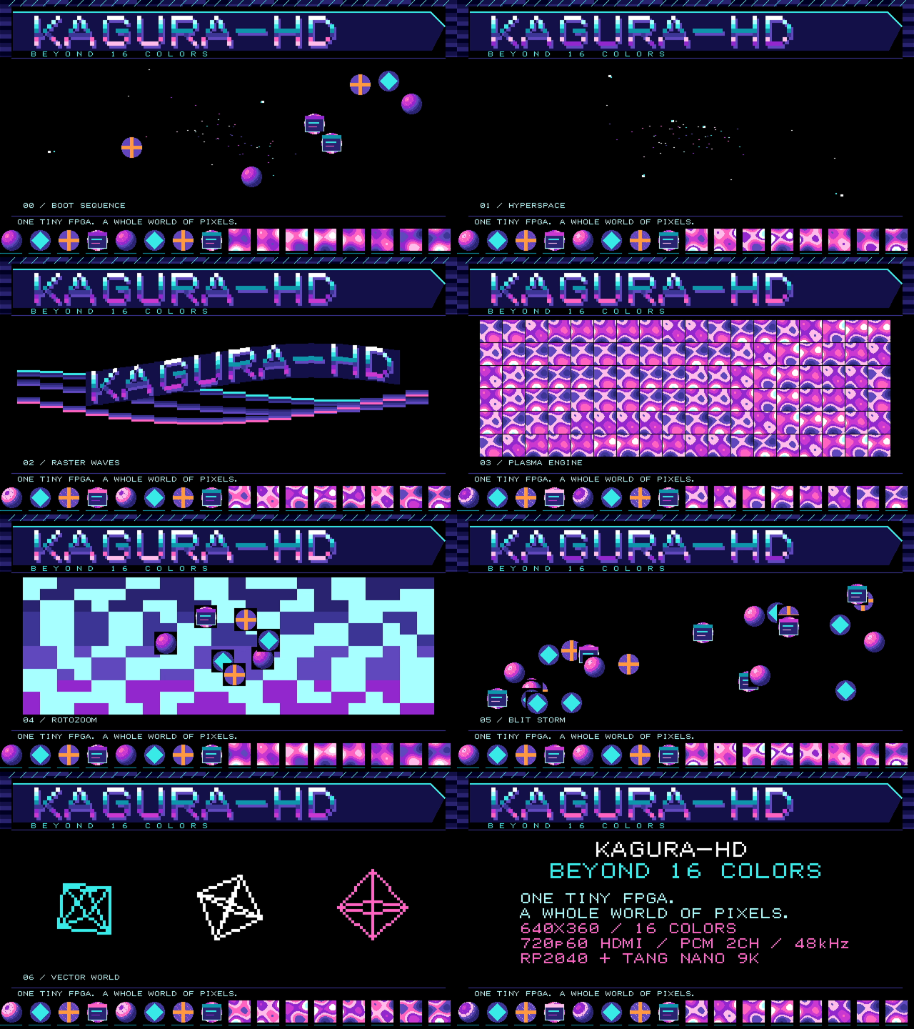
docs/evidence/gpu-completion-abab/baseline-1/contact-sheet.png
