siska-tech/kagura-hd/docs/evidence/gpu-completion-abab/baseline-2/00.png

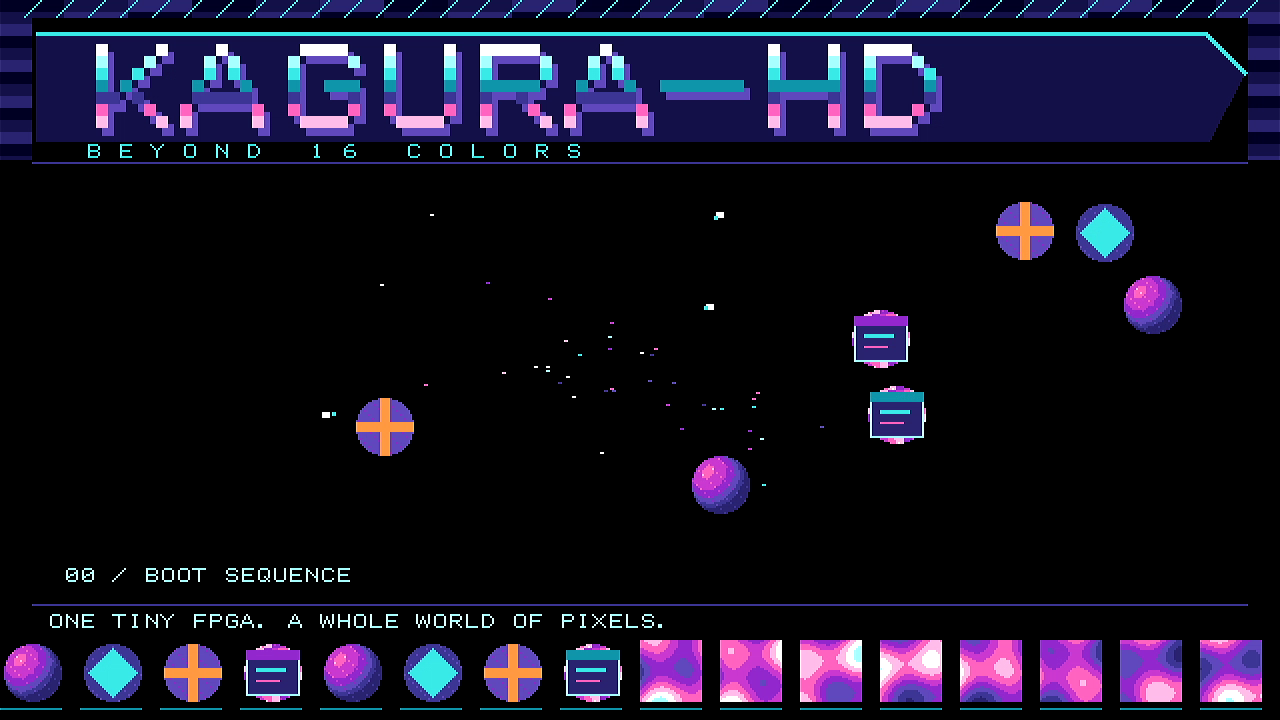
docs/evidence/gpu-completion-abab/baseline-2/00.png
