siska-tech/kagura-hd/docs/evidence/gpu-completion-abab/burst-1/05.png

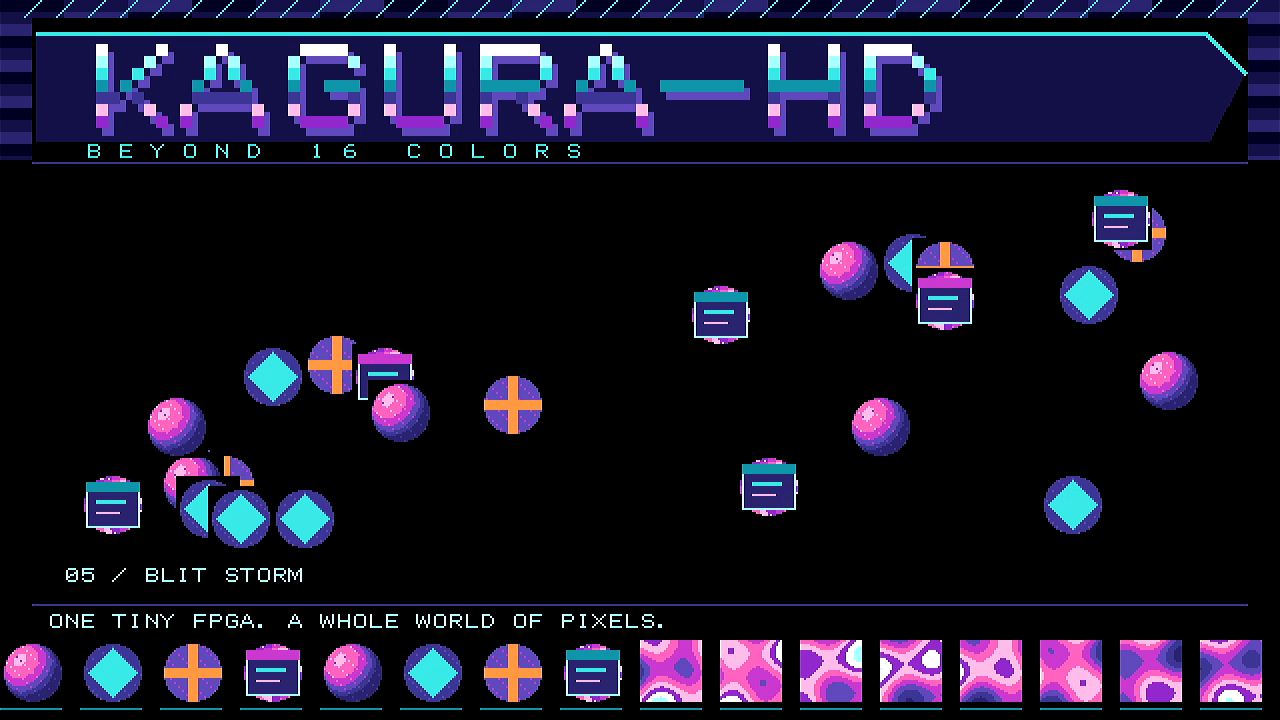
docs/evidence/gpu-completion-abab/burst-1/05.png
