siska-tech/kagura-hd/docs/evidence/gpu-completion-abab/burst-2/01.png

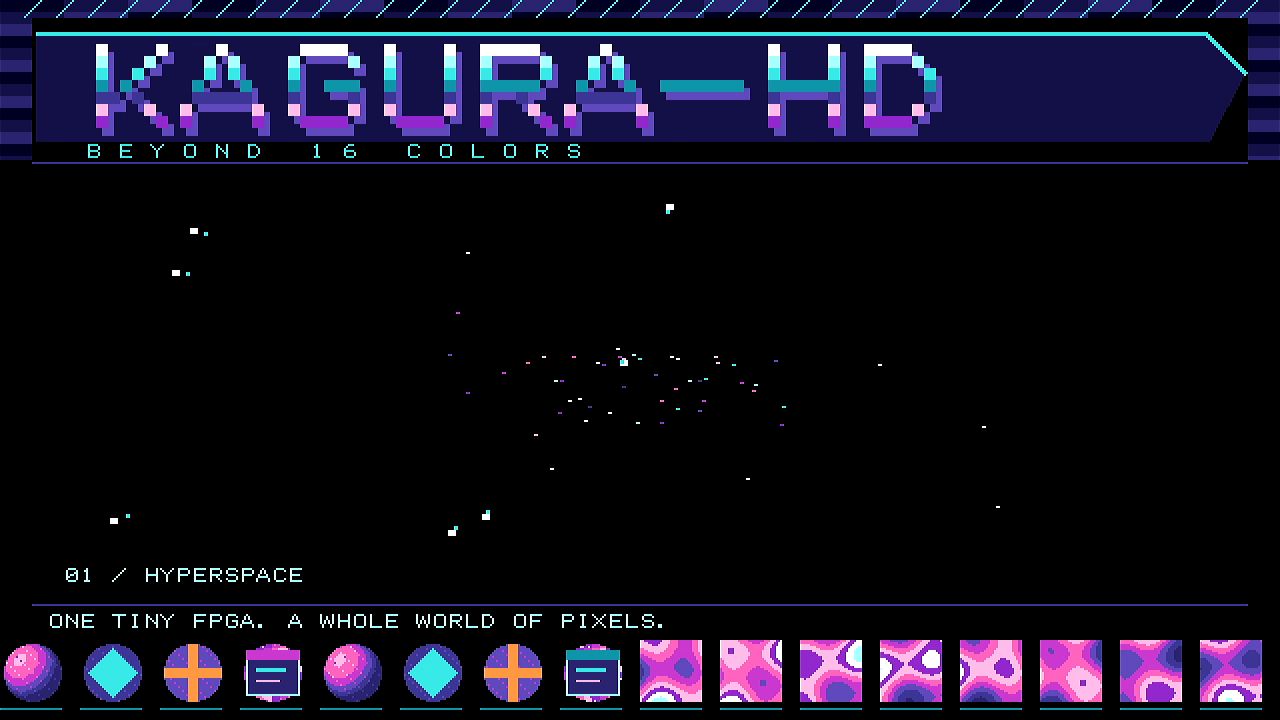
docs/evidence/gpu-completion-abab/burst-2/01.png
