siska-tech/kagura-hd/docs/evidence/gpu-queue-demo/serial/04.png

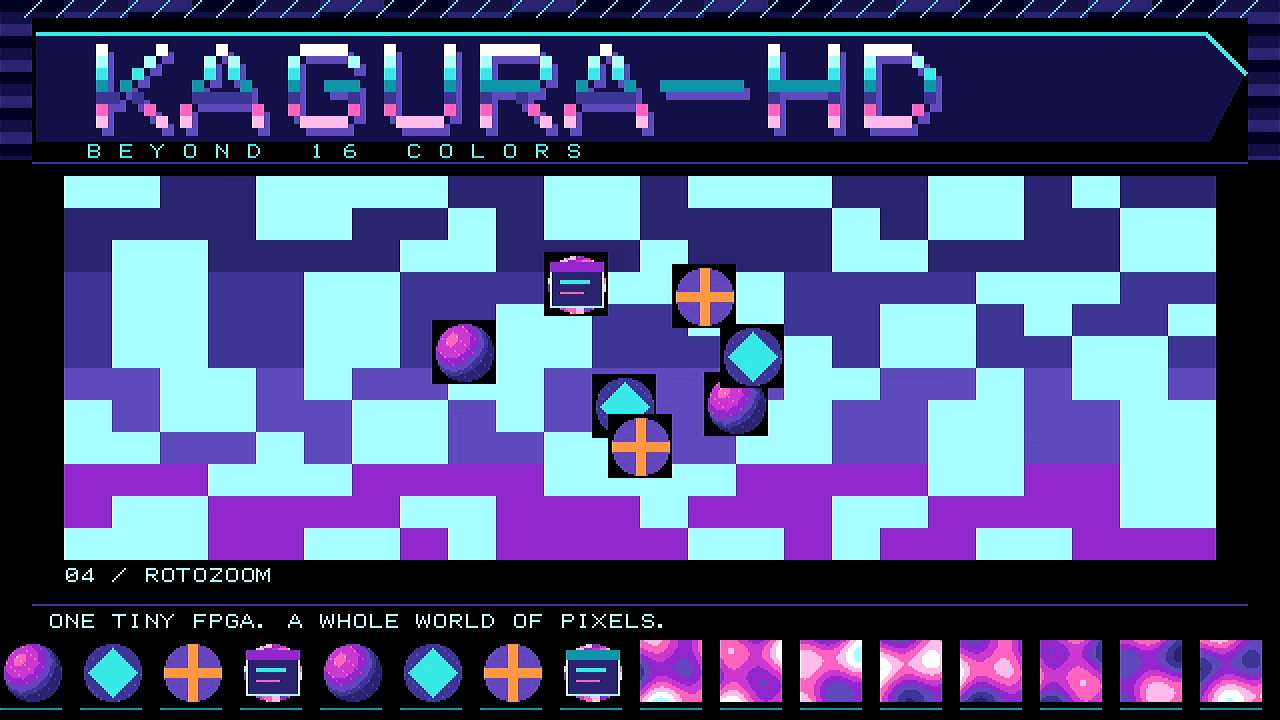
docs/evidence/gpu-queue-demo/serial/04.png
