siska-tech/kagura-hd/docs/evidence/queue8-deglitch-release/hardware/04.png

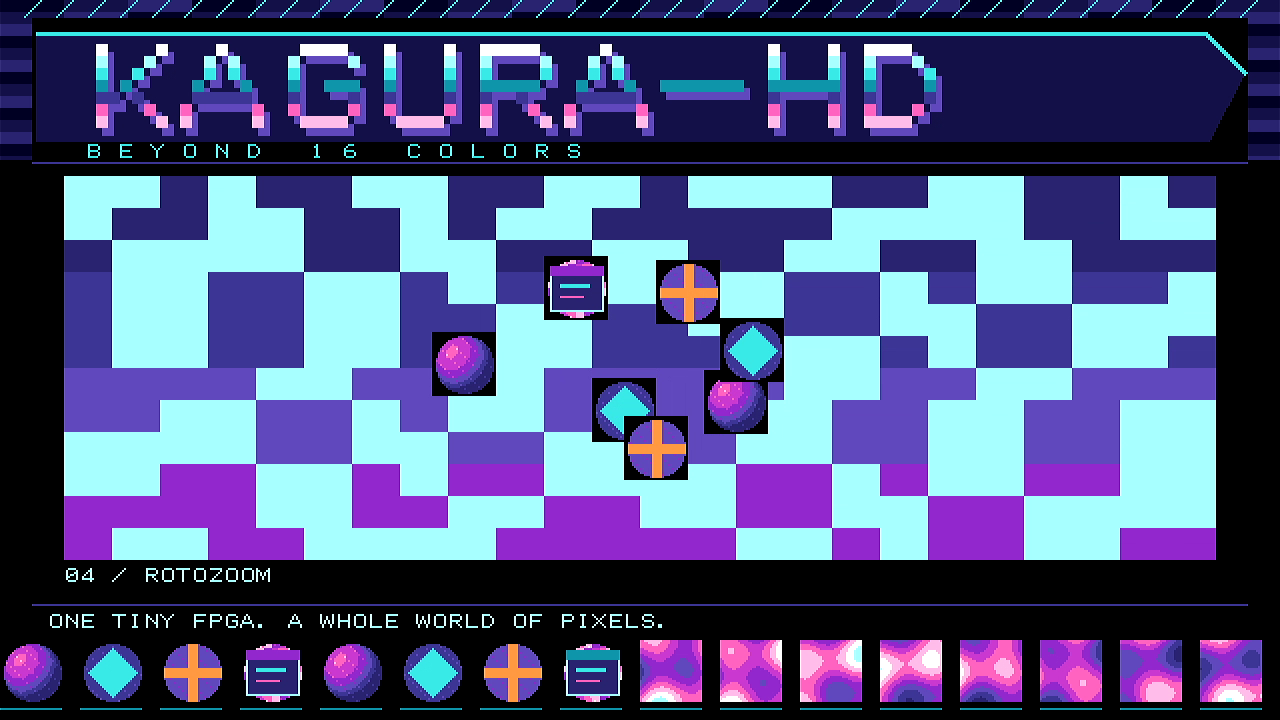
docs/evidence/queue8-deglitch-release/hardware/04.png
