siska-tech/kagura-hd/software/beyond16/evidence/00-BOOT.png

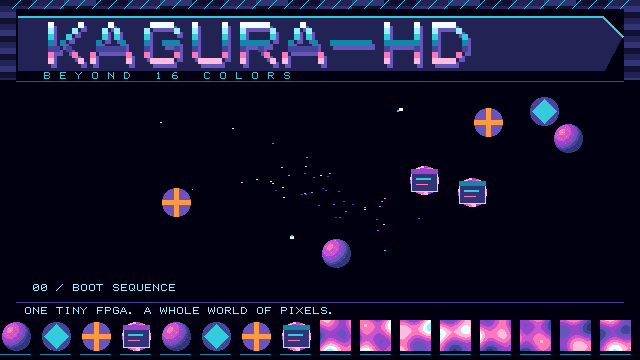
software/beyond16/evidence/00-BOOT.png
