siska-tech/kagura-hd/software/beyond16/evidence/01-HYPERSPACE.png

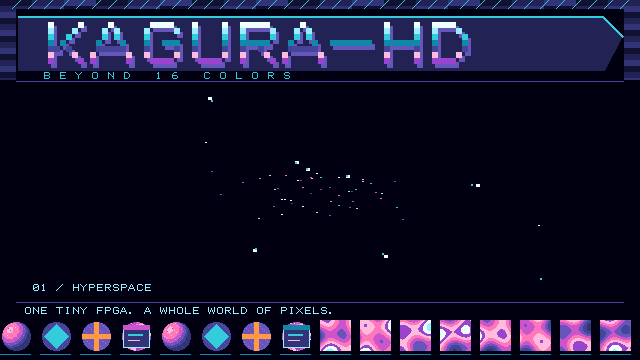
software/beyond16/evidence/01-HYPERSPACE.png
