siska-tech/kagura-hd/software/beyond16/evidence/02-RASTER-WAVES.png

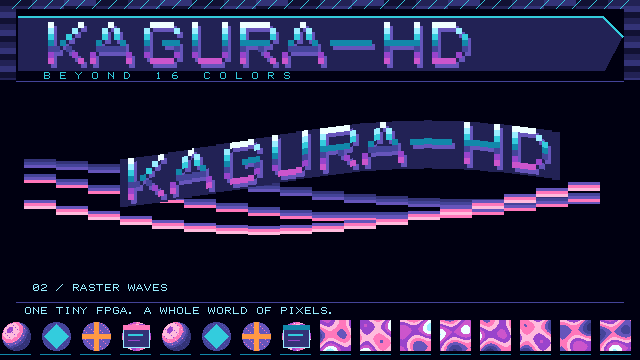
software/beyond16/evidence/02-RASTER-WAVES.png
