siska-tech/kagura-hd/software/beyond16/evidence/07-FINALE.png

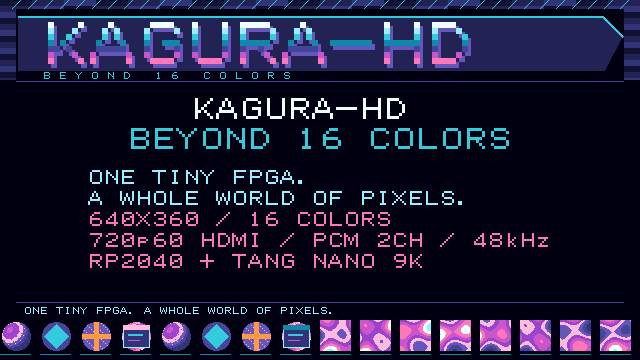
software/beyond16/evidence/07-FINALE.png
