siska-tech/kagura-hd/software/beyond16/evidence/hardware-optimized/03-hardware.png

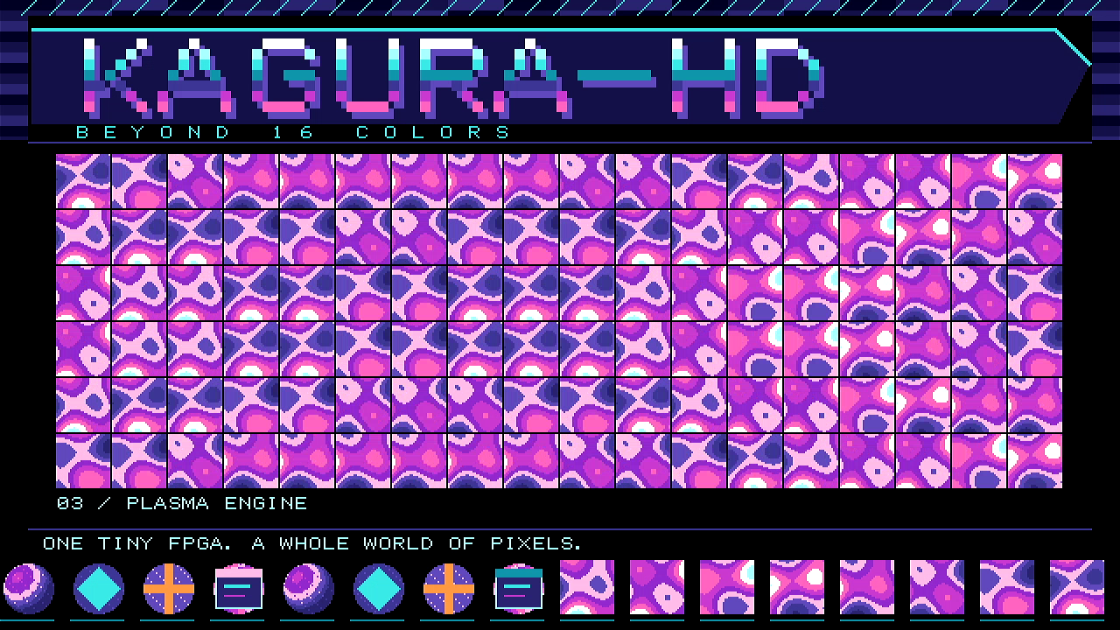
software/beyond16/evidence/hardware-optimized/03-hardware.png
