siska-tech/kagura-hd/software/beyond16/evidence/hardware-optimized/04-hardware.png

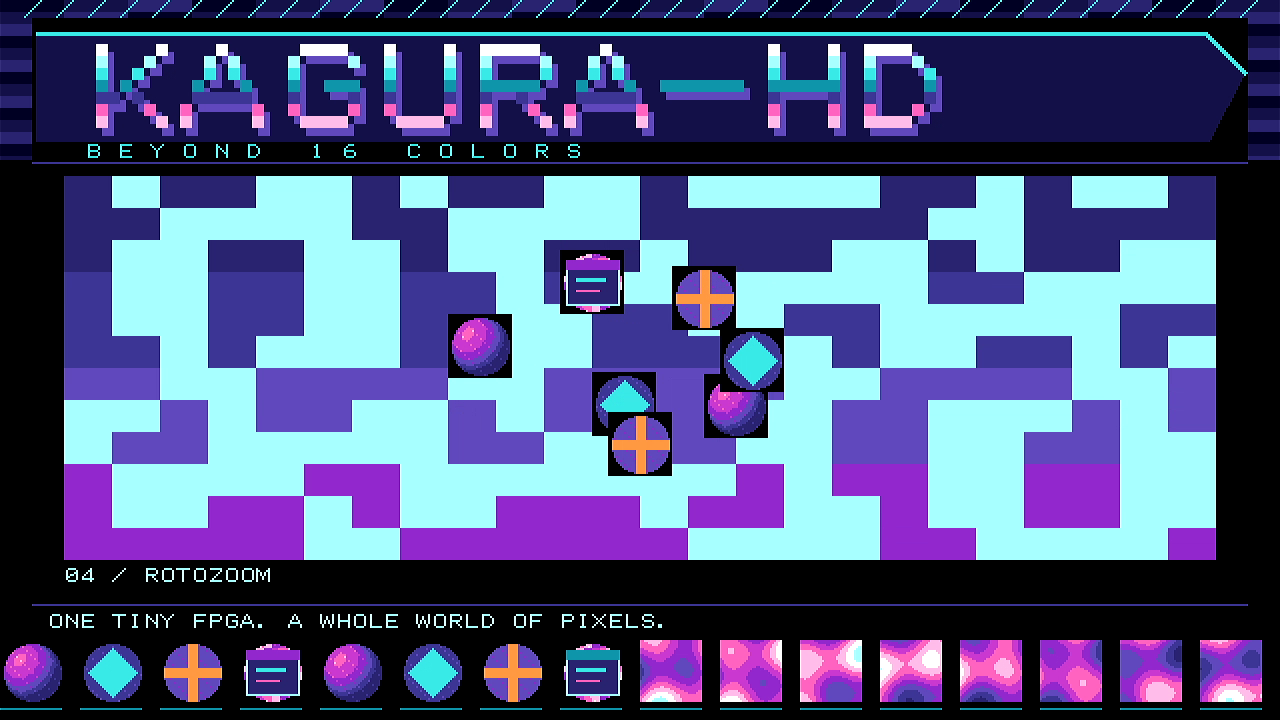
software/beyond16/evidence/hardware-optimized/04-hardware.png
