siska-tech/kagura-hd/software/beyond16/evidence/headroom-hardware/A-detailed/01-hardware.png

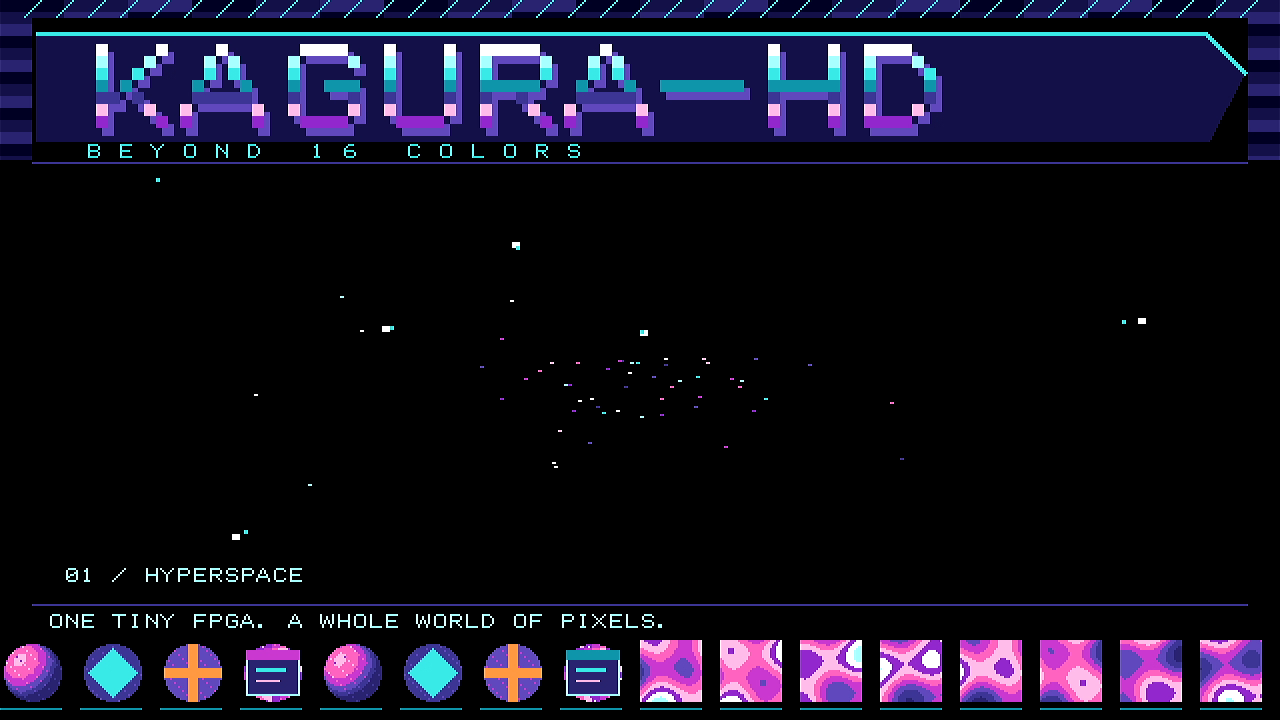
software/beyond16/evidence/headroom-hardware/A-detailed/01-hardware.png
