siska-tech/kagura-hd/software/beyond16/evidence/headroom-hardware/A-detailed/04-hardware.png

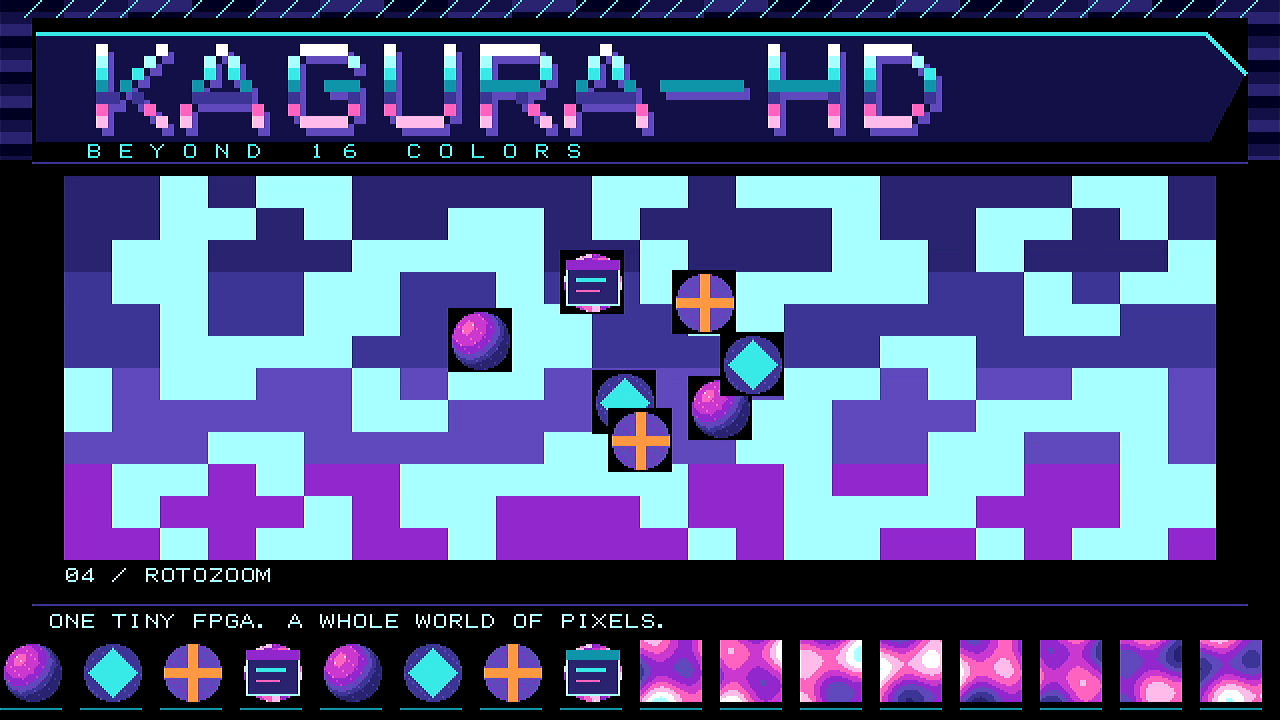
software/beyond16/evidence/headroom-hardware/A-detailed/04-hardware.png
