siska-tech/kagura-hd/software/beyond16/evidence/vector-lowres-126996.png

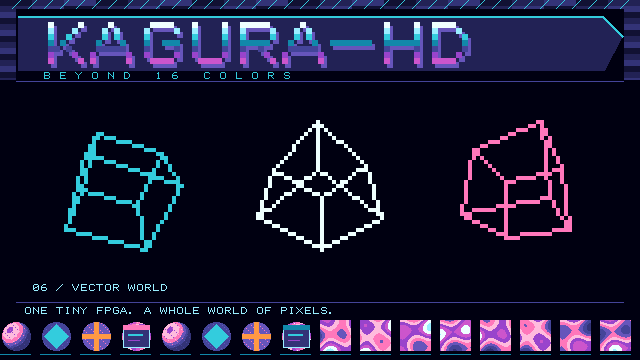
software/beyond16/evidence/vector-lowres-126996.png
