siska-tech/kagura-hd/software/beyond16/evidence/vector-lowres-139998.png

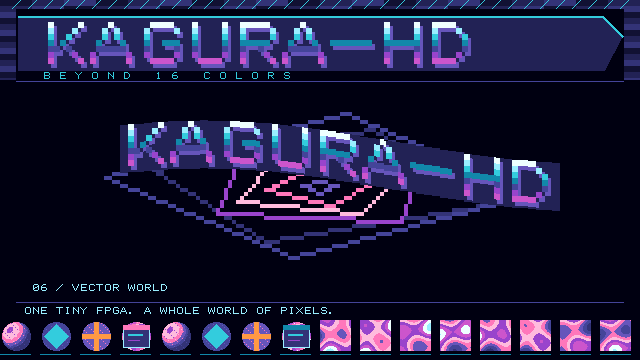
software/beyond16/evidence/vector-lowres-139998.png
