siska-tech/kagura-hd/software/beyond16/evidence/vector-tunnel.png

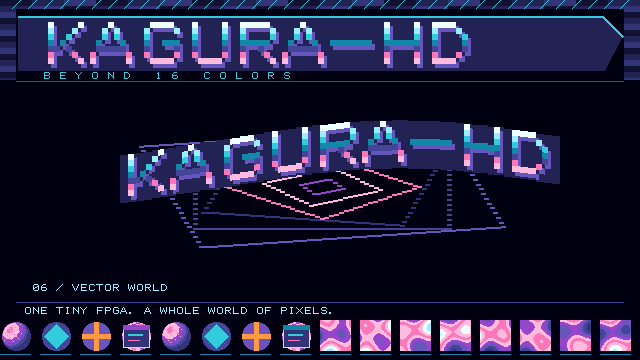
software/beyond16/evidence/vector-tunnel.png
