siska-tech/kagura-hd/software/beyond16/generated/frame-atlas.png

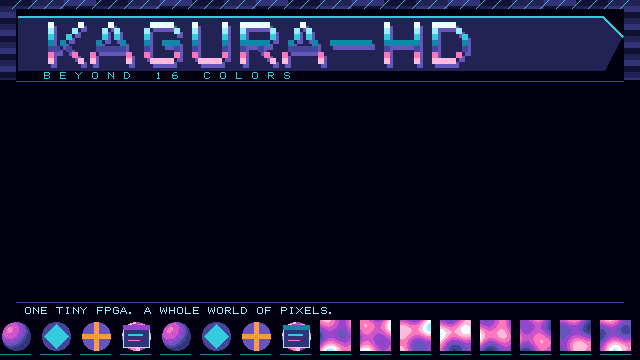
software/beyond16/generated/frame-atlas.png
