siska-tech/kagura-hd/software/fm_megademo/evidence/hardware-contact-sheet.png

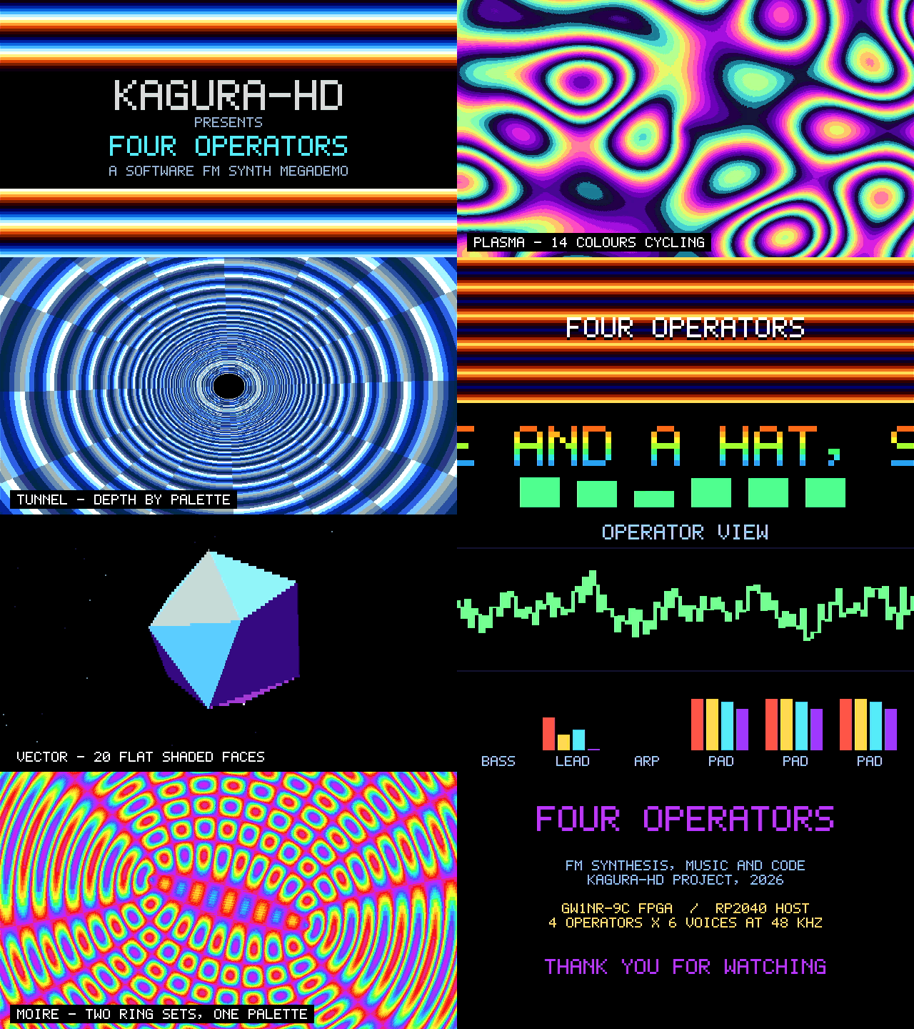
software/fm_megademo/evidence/hardware-contact-sheet.png
