siska-tech/kagura-hd/software/midnight_terminal/art/bar-reference-640x360.png

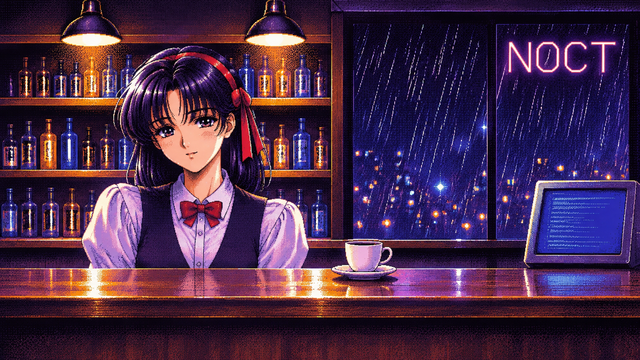
software/midnight_terminal/art/bar-reference-640x360.png
