siska-tech/kagura-hd/software/midnight_terminal/art/blink-reference-eyes.png

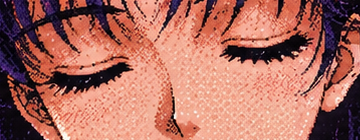
software/midnight_terminal/art/blink-reference-eyes.png
