siska-tech/kagura-hd/software/midnight_terminal/evidence/hardware-blink.png

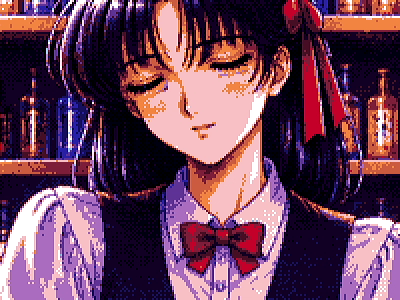
software/midnight_terminal/evidence/hardware-blink.png
