siska-tech/kagura-hd/software/midnight_terminal/evidence/hardware-contact-sheet.png

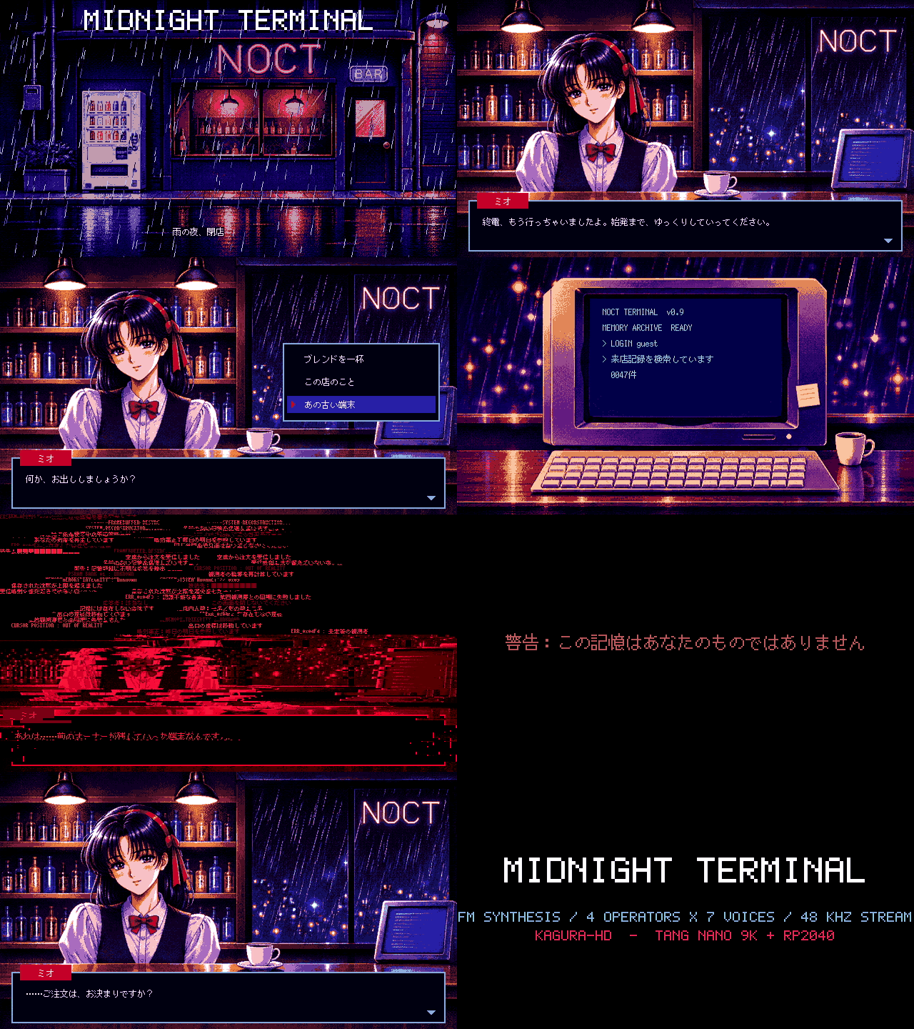
software/midnight_terminal/evidence/hardware-contact-sheet.png
