siska-tech/kagura-hd/releases/pcm-stream-spi/build-inputs/rtl/audio/kagura_audio_registers.sv

// SPDX-License-Identifier: Apache-2.0
// Indexed shadow registers and the one outstanding AUDIO_COMMIT snapshot.
// Capture is driven only by successful queue admission; completion comes
// from the ordered engine after the synthesizer has applied the snapshot.
// With PCM, indices 60..7F / 80..9F are PCM channel 0 / 1 (ABI 0.4):
// +00..02 START, +04..06 END, +08..0A LOOP (24-bit addresses), +0C GAIN_L,
// +0D GAIN_R, +0E CONTROL (b0 ENABLE, b1 LOOP_ENABLE), +0F write PCM_CMD
// (b0 PREPARE, b1 STOP, b2 CLEAR) / read PCM_STATUS (kagura_pcm_control).
// GAIN and ENABLE join the AUDIO_COMMIT snapshot; START/END/LOOP/LOOP_ENABLE
// are taken when a PREPARE is accepted. Other offsets read 0, writes ignored.
module kagura_audio_registers #(
    parameter bit PCM=0,
    parameter bit PCM_ONLY=0
) (
    input wire clk,reset,index_write,data_write,
    input wire [7:0] wdata,
    output reg [7:0] index,
    output reg [7:0] rdata,
    output reg read_legal,write_legal,
    output reg settings_valid,
    input wire capture,commit_done,
    output reg apply_busy,
    input wire underflow_event,overflow_event,muted,
    output wire [7:0] status,
    output reg [143:0] snapshot_step,
    output reg [23:0] snapshot_duty,
    output reg [47:0] snapshot_l,snapshot_r,
    output reg [5:0] snapshot_enable,snapshot_reset,
    output reg [7:0] snapshot_len,snapshot_master,
    output reg [15:0] snapshot_period,
    // PCM (tied off without PCM)
    output reg [47:0] pcm_start,pcm_end,pcm_loop,   // {ch1, ch0}
    output reg [1:0] pcm_loop_enable,
    output reg [1:0] pcm_prepare,pcm_stop,pcm_clear,
    input wire [15:0] pcm_status,                   // {ch1, ch0}
    output reg [15:0] snapshot_pcm_l,snapshot_pcm_r,
    output reg [1:0] snapshot_pcm_enable,
    output wire settle               // hold the next request until PCM_STATUS reflects a PCM_CMD
);
    reg [143:0] steps;
    reg [23:0] duties;
    reg [47:0] gains_l,gains_r;
    reg [5:0] enables,resets;
    reg [15:0] lengths,noise_period;
    reg [7:0] master;
    reg underflow,overflow;
    reg capture_pending;
    reg [5:0] captured_resets;
    wire [2:0] ch=index[6:4];
    wire [3:0] offset=index[3:0];
    wire channel_index=!PCM_ONLY && index<8'h60;
    wire pcm_index=PCM && index>=8'h60 && index<8'ha0;
    wire pcm_ch=index[7];              // 60..7F -> 0, 80..9F -> 1
    wire [4:0] pcm_off=index[4:0];
    reg [15:0] pcm_gain_l,pcm_gain_r;
    reg [1:0] pcm_enable;
    reg [7:0] pcm_data;
    assign status={4'b0,muted,overflow,underflow,apply_busy};
    reg [7:0] channel_data [0:5];
    reg [7:0] global_data;
    reg valid_settings;
    wire pcm_cmd_write=data_write && pcm_index && pcm_off==5'h0f;
    // Registered: the command reaches the prefetcher one cycle later, keeping
    // the register decode out of its sample-count path.
    // A PCM command takes effect two cycles after the write and the status cache
    // one more, so `settle` stalls the next register request for three cycles
    // after any audio data write.
    reg [2:0] settle_sr;
    assign settle=|settle_sr;
    // Shadow writes land one cycle after the register stage (the write enable
    // fans out to every shadow register); `settle` covers them as well.
    reg dw_q;
    reg [7:0] wd_q;
    always @(posedge clk)
        if(reset) begin pcm_prepare<=0; pcm_stop<=0; pcm_clear<=0; settle_sr<=0; dw_q<=0; wd_q<=0; end
        else begin
            settle_sr<={settle_sr[1:0],data_write || index_write};
            dw_q<=data_write && write_legal;
            wd_q<=wdata;
            pcm_prepare<={pcm_cmd_write && pcm_ch && wdata[0],pcm_cmd_write && !pcm_ch && wdata[0]};
            pcm_stop<={pcm_cmd_write && pcm_ch && wdata[1],pcm_cmd_write && !pcm_ch && wdata[1]};
            pcm_clear<={pcm_cmd_write && pcm_ch && wdata[2],pcm_cmd_write && !pcm_ch && wdata[2]};
        end
    // Read data and legality are registered one cycle after the caches below,
    // keeping the index decode out of the bus response and error paths; index
    // writes therefore also hold the next request through `settle`.
    reg [7:0] rdata_c;
    reg read_legal_c,write_legal_c;
    always @(posedge clk) begin rdata<=rdata_c; read_legal<=read_legal_c; write_legal<=write_legal_c; end
    always @* begin
        rdata_c=0; read_legal_c=1; write_legal_c=channel_index || pcm_index;
        if(channel_index) begin
            for(integer c=0;c<6;c=c+1) rdata_c=rdata_c | (channel_data[c] & {8{ch==c}});
        end else if(pcm_index) begin
            rdata_c=pcm_data;
        end else begin
            rdata_c=global_data;
            case(index)
            8'he0: write_legal_c=1;
            8'he1: ;
            8'he2: begin read_legal_c=0; write_legal_c=1; end
            default: ;
            endcase
        end
        if(PCM_ONLY && index<8'h60) begin read_legal_c=0;write_legal_c=0;end
        valid_settings=lengths[7:0]>=5 && lengths[7:0]<=8 && lengths[15:8]>=5 && lengths[15:8]<=8;
        for(integer c=0;c<6;c=c+1) if(c!=3 && steps[24*c+23]) valid_settings=0;
        if(PCM_ONLY) valid_settings=1;
    end
    // Predecode the offset for each channel in parallel, then select the
    // channel into the ordinary bus response. The two-edge request interval
    // leaves one edge after every index/shadow write for this cache.
    always @(posedge clk)
        if(reset) begin
            for(integer c=0;c<6;c=c+1) channel_data[c]<=0;
            global_data<=0; settings_valid<=1; pcm_data<=0;
        end else begin
            settings_valid<=valid_settings;
            global_data<=index==8'he0 ? master : index==8'he1 ? status : 8'b0;
            pcm_data<=0;
            if(PCM) case(pcm_off)
                5'h00: pcm_data<=pcm_start[24*pcm_ch +:8];
                5'h01: pcm_data<=pcm_start[24*pcm_ch+8 +:8];
                5'h02: pcm_data<=pcm_start[24*pcm_ch+16 +:8];
                5'h04: pcm_data<=pcm_end[24*pcm_ch +:8];
                5'h05: pcm_data<=pcm_end[24*pcm_ch+8 +:8];
                5'h06: pcm_data<=pcm_end[24*pcm_ch+16 +:8];
                5'h08: pcm_data<=pcm_loop[24*pcm_ch +:8];
                5'h09: pcm_data<=pcm_loop[24*pcm_ch+8 +:8];
                5'h0a: pcm_data<=pcm_loop[24*pcm_ch+16 +:8];
                5'h0c: pcm_data<=pcm_gain_l[8*pcm_ch +:8];
                5'h0d: pcm_data<=pcm_gain_r[8*pcm_ch +:8];
                5'h0e: pcm_data<={6'b0,pcm_loop_enable[pcm_ch],pcm_enable[pcm_ch]};
                5'h0f: pcm_data<=pcm_status[8*pcm_ch +:8];
                default: ;
            endcase
            for(integer c=0;c<6;c=c+1) begin
                channel_data[c]<=0;
                case(offset)
                    0: if(c!=3) channel_data[c]<=steps[24*c +:8];
                    1: if(c!=3) channel_data[c]<=steps[24*c+8 +:8];
                    2: if(c!=3) channel_data[c]<=steps[24*c+16 +:8];
                    3: if(c<3) channel_data[c]<=duties[8*c +:8];
                    4: channel_data[c]<=gains_l[8*c +:8];
                    5: channel_data[c]<=gains_r[8*c +:8];
                    6: channel_data[c]<={6'b0,resets[c],enables[c]};
                    7: if(c>=4) channel_data[c]<=lengths[8*(c-4) +:8];
                    8: if(c==3) channel_data[c]<=noise_period[7:0];
                    9: if(c==3) channel_data[c]<=noise_period[15:8];
                    default: ;
                endcase
            end
        end
    wire clear_underflow=data_write && index==8'he2 && wdata[1];
    wire clear_overflow=data_write && index==8'he2 && wdata[2];
    always @(posedge clk)
        if(reset) begin
            index<=0; steps<=0; duties<=0; gains_l<=0; gains_r<=0; enables<=0; resets<=0;
            lengths<=16'h0505; noise_period<=0; master<=32; underflow<=0; overflow<=0; apply_busy<=0;
            capture_pending<=0; captured_resets<=0;
            snapshot_step<=0; snapshot_duty<=0; snapshot_l<=0; snapshot_r<=0;
            snapshot_enable<=0; snapshot_reset<=0; snapshot_len<=8'h55; snapshot_master<=32; snapshot_period<=0;
            pcm_start<=0; pcm_end<=0; pcm_loop<=0; pcm_loop_enable<=0; pcm_gain_l<=0; pcm_gain_r<=0; pcm_enable<=0;
            snapshot_pcm_l<=0; snapshot_pcm_r<=0; snapshot_pcm_enable<=0;
        end else begin
            capture_pending<=capture;
            underflow<=(underflow && !clear_underflow) || underflow_event;
            overflow<=(overflow && !clear_overflow) || overflow_event;
            if(index_write) index<=wdata;
            if(dw_q) begin
                if(channel_index) begin
                    for(integer c=0;c<6;c=c+1) if(ch==c) case(offset)
                        0: if(c!=3) steps[24*c +:8]<=wd_q;
                        1: if(c!=3) steps[24*c+8 +:8]<=wd_q;
                        2: if(c!=3) steps[24*c+16 +:8]<=wd_q;
                        3: if(c<3) duties[8*c +:8]<=wd_q;
                        4: gains_l[8*c +:8]<=wd_q;
                        5: gains_r[8*c +:8]<=wd_q;
                        6: begin enables[c]<=wd_q[0]; resets[c]<=wd_q[1]; end
                        7: if(c>=4) lengths[8*(c-4) +:8]<=wd_q;
                        8: if(c==3) noise_period[7:0]<=wd_q;
                        9: if(c==3) noise_period[15:8]<=wd_q;
                        default: ;
                    endcase
                end
                else if(pcm_index) case(pcm_off)
                    5'h00: pcm_start[24*pcm_ch +:8]<=wd_q;
                    5'h01: pcm_start[24*pcm_ch+8 +:8]<=wd_q;
                    5'h02: pcm_start[24*pcm_ch+16 +:8]<=wd_q;
                    5'h04: pcm_end[24*pcm_ch +:8]<=wd_q;
                    5'h05: pcm_end[24*pcm_ch+8 +:8]<=wd_q;
                    5'h06: pcm_end[24*pcm_ch+16 +:8]<=wd_q;
                    5'h08: pcm_loop[24*pcm_ch +:8]<=wd_q;
                    5'h09: pcm_loop[24*pcm_ch+8 +:8]<=wd_q;
                    5'h0a: pcm_loop[24*pcm_ch+16 +:8]<=wd_q;
                    5'h0c: pcm_gain_l[8*pcm_ch +:8]<=wd_q;
                    5'h0d: pcm_gain_r[8*pcm_ch +:8]<=wd_q;
                    5'h0e: begin pcm_enable[pcm_ch]<=wd_q[0]; pcm_loop_enable[pcm_ch]<=wd_q[1]; end
                    default: ;
                endcase
                else if(index==8'he0) master<=wd_q;
            end
            if(commit_done) apply_busy<=0;
            if(capture) begin
                apply_busy<=1;
                captured_resets<=resets; resets<=0;
            end
            // Shadow registers cannot be written on the following edge:
            // the bus request stage enforces a two-edge access interval.
            // Stage the high-fanout snapshot enable in that unused edge.
            if(capture_pending) begin
                snapshot_step<=steps; snapshot_duty<=duties; snapshot_l<=gains_l; snapshot_r<=gains_r;
                snapshot_enable<=enables; snapshot_reset<=captured_resets;
                snapshot_len<={lengths[11:8],lengths[3:0]}; snapshot_master<=master; snapshot_period<=noise_period;
                if(PCM) begin snapshot_pcm_l<=pcm_gain_l; snapshot_pcm_r<=pcm_gain_r; snapshot_pcm_enable<=pcm_enable; end
            end
        end
// synthesis translate_off
    always @(posedge clk)
        if(!reset && capture && (apply_busy || !settings_valid)) $fatal(1,"invalid audio snapshot admission");
// synthesis translate_on
endmodule
