siska-tech/kagura-hd/diagnostics/pcm-stream-rc1/regress.py

#!/usr/bin/env python3
"""Run in WSL/Linux with Verilator; no synthesis or hardware access."""
import argparse
import hashlib
import json
from pathlib import Path
import shutil
import subprocess

root = Path(__file__).resolve().parents[2]
diag = Path(__file__).resolve().parent
parser = argparse.ArgumentParser()
parser.add_argument('--output', required=True, type=Path)
parser.add_argument('--present-rx-stage', action='store_true')
parser.add_argument('--fill-end-adder', action='store_true')
parser.add_argument('--generation-carry', action='store_true')
parser.add_argument('--window-commit-merge', action='store_true')
parser.add_argument('--palette-ram', action='store_true')
parser.add_argument('--window-word-select', action='store_true')
args = parser.parse_args()
out = args.output.resolve()
out.mkdir(parents=True, exist_ok=False)
release = root / 'releases/queue8-qspi-deglitch-rc1'
baseline = release / 'build-inputs'
def digest(p):
    return hashlib.sha256(p.read_bytes()).hexdigest()
for name, expected in json.loads((release / 'source-input-manifest.json').read_text()).items():
    if digest(baseline / name).lower() != expected.lower():
        raise RuntimeError(f'RC1 hash mismatch: {name}')
inputs = out / 'inputs'
shutil.copytree(baseline, inputs)
patches = ['stream.patch', 'tx-sta.patch', 'window-sta.patch', 'control-sta.patch']
if args.present_rx_stage:
    patches.append('present-rx-sta.patch')
if args.fill_end_adder:
    patches.append('fill-end-sta.patch')
if args.generation_carry:
    patches.append('generation-sta.patch')
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
