siska-tech/kagura-hd/(commit log)

2026-11-04 Initial public snapshot of KAGURA-HD
    [pin-inventory.csv]
2026-11-05 Publish PCM2 demo snapshot and quarantine SPI STA failure
    [psram-byte-diff.csv]
2026-11-05 Keep YouTube publishing materials local
2026-11-08 Add Queue8 GPU work, QSPI CS deglitch RC1 and the PCM streaming FPGA sources
    - RTL/board top now match the selected PCM streaming build inputs
    (Queue8 command queue, QSPI CS deglitch, A/B half PCM streaming,
    per-word upload window select with diagnostic CSR 31 bit1).
    - Simulation and evaluation tools for the command queue, decode, ACK
    observation, packet-first and audio credit experiments.
    - diagnostics/pcm-stream-rc1: design audit, hardware A/B evidence,
    T8 diagnostic build, G1 adoption gate and promotion records.
    - Queue8 diagnostics, RC1 local release package and GPU evidence.
2026-11-08 Promote the PCM streaming QSPI bitstream to the selected release
    - artifacts/validated/kagura-hd-qspi-pcm-stream.fs (fad15376...), STA
    +0.177/+0.527 ns, G1 certification (53 hardware runs), CSR 31 safety
    simulation, byte-identical reproduction and a 150 s BEYOND 16 COLORS
    regression on hardware.
    - releases/pcm-stream-qspi: 41 frozen inputs, P&R settings, timing,
    validation records and reproduce.ps1 (netlist checked by body hash).
    - PCM2 QSPI kept as superseded; release catalogue, checksums and
    tools/check-release.py now point at the new package.
    - Fix package-relative links in licenses/THIRD_PARTY.md and the old
    MIDNIGHT link (checksums updated).
    - Host API: PCM streaming CSR sec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
    [check-release.py, kagura_async_fifo.sv, kagura_audio_packets.sv, kagura_audio_registers.sv, kagura_audio_synth.sv, kagura_audio_transport.sv]
2026-11-08 README: demos with videos and screenshots, refreshed documentation
    Top-level README leads with FOUR OPERATORS and MIDNIGHT TERMINAL
    (YouTube thumbnails and hardware screenshots), describes the selected
    PCM streaming bitstream and its two-stage reproduction, and the docs
    index, cleanup history and validation records are updated.
2026-11-08 Release UF2s for FOUR OPERATORS and MIDNIGHT TERMINAL
    Both demos gain a KAGURA_AUTOSTART_MS build option (0 by default, which
    keeps the host-driven builds unchanged): the release image starts five
    seconds after power-up unless a terminal opens the USB serial port, and
    prints its summary again when one connects. FOUR OPERATORS is built as a
    copy_to_ram Flash image for the release. build_rp2040.ps1 -Release makes
    the UF2 with picotool, and run_hardware.py --flash --autostart --uf2
    verifies it on hardware without starting it from the host.
    Both release UF2s ran to completion on hardware (rc=0, no audio
    dropouts); the RP2040 Flash was restored byte-for-byte afterwards.
    README, demo READMEs and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
2026-11-08 Verify the release steps with the bitstream in FPGA Flash
    run_hardware.py --fpga-from-flash reconfigures the FPGA from its Flash
    instead of loading SRAM. With the selected bitstream written to the
    Tang Nano 9K Flash, the MIDNIGHT TERMINAL release UF2 ran to completion
    (rc=0, no audio dropouts). Notes for writing the Flash: the bitstream has
    SecurityBit ON, so operations with Verify fail; Programmer 1.9.11.03
    wrote it, while 1.9.12.04 programmer_cli failed on this board.
    [run_hardware.py]
2026-11-09 Close SPI timing with an SPI-only RTL overlay
    SPI and QSPI stay build-time exclusive. tools/build-fb.tcl swaps in
    same-named files from rtl/spi/ only for the spi transport, so the QSPI
    build keeps the frozen inputs: a branch QSPI build reproduces the
    selected netlist body (79434504...) and check-release.py passes.
    The overlay enables the RC1 /CS-high qualification for SPI, moves the
    palette and cursor-color clock-domain crossings into BSRAM, and
    registers the READ/WRITE address and the per-line row values. With
    Queue8/PACKET_FIRST at P4/R2 the SPI build meets the numeric gate:
    setup +0.159 ns, hold +0.456 ns, 0/0 violations, recovery +8.190 ns,
    removal +0.533 ns (CLS 4245/4320, BSRAM 25/26)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
    [kagura_fb_commands.sv, kagura_fb_cursor.sv, kagura_fb_scanout.sv, kagura_spi_adapter.sv]
2026-11-09 Run the three demos on the SPI build
    The shared demo transport (beyond16/src/b16_qspi.c) gets a build-time
    SPI mode: B16_HOST_LANES=1 (CMake -DKAGURA_HOST_LANES=1) loads the
    KAGURA-9 kagura_spi PIO program, drives only IO0 and reads MISO on IO1.
    The default stays QSPI; the QSPI builds of all three demos are
    byte-identical to the previous ones.
    With the SPI bitstream (e9f67c68...) in FPGA SRAM and SPI at 5 MHz,
    FOUR OPERATORS, MIDNIGHT TERMINAL and BEYOND 16 COLORS all ran to
    completion: no timeouts, no audio faults, no 10 ms audio dropouts.
    Frame counts are 3-14% lower than QSPI. The RP2040 Flash was restored
    and verified, and the FPGA SRAM restored to the approved Queue8.
    run_hardware.py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
2026-11-09 Sweep the SPI clock from 5 to 10 MHz on hardware
    Same SPI bitstream, host PIO divider only. 5, 6 and 8 MHz pass the
    BEYOND 16 COLORS bench (PSRAM write/read with compare) and demo, and
    FOUR OPERATORS, with no timeouts, audio faults or 10 ms dropouts.
    10 MHz fails at device identification (KFB_DEVICE / KFB_VERSION).
    At 8 MHz, raw writes reach 0.89 MB/s (QSPI 5 MHz: 1.14 MB/s) and demo
    frame counts are within 1.4% (BEYOND 16) and 4.8% (FOUR OPERATORS)
    of QSPI.
    run-beyond16.py takes --modes bench,demo and force-reboots between
    modes.
2026-11-09 Release the SPI configuration alongside QSPI
    SPI is an optional, build-time exclusive configuration for hosts without
    QSPI. The QSPI release, its package and its bitstream are unchanged.
    - releases/pcm-stream-spi: 45 frozen inputs (the QSPI inputs, the
    rtl/spi overlay and build-fb.tcl), STA reports, manifest, checksums,
    reproduce.ps1 (rebuilds netlist, .bin and .fs identically), the
    simulation log, the UF2-vs-ELF check, the clock sweep and the hardware
    evidence.
    - artifacts/validated/kagura-hd-spi-pcm-stream.fs (e9f67c68...),
    listed in releases/SHA256SUMS and candidates.json. The PCM2 SPI
    STA-fail build stays in experimental as a superseded record.
    - check-release.py checks the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
    [check-release.py, kagura_async_fifo.sv, kagura_audio_packets.sv, kagura_audio_registers.sv, kagura_audio_synth.sv, kagura_audio_transport.sv]
2026-11-09 Document the SPI assets in release v2026.11.09.1
    Fix the clock-sweep note that said MIDNIGHT TERMINAL ran only at 5 MHz,
    list the QSPI and SPI UF2s separately, and record the release tag in the
    SPI manifest. QSPI files and bitstreams are unchanged.
